Singleboardcomputer/hardware_for_kintex/config-spi.kicad_sch

## KiCad design config-spi.kicad_sch (2023-09-25)

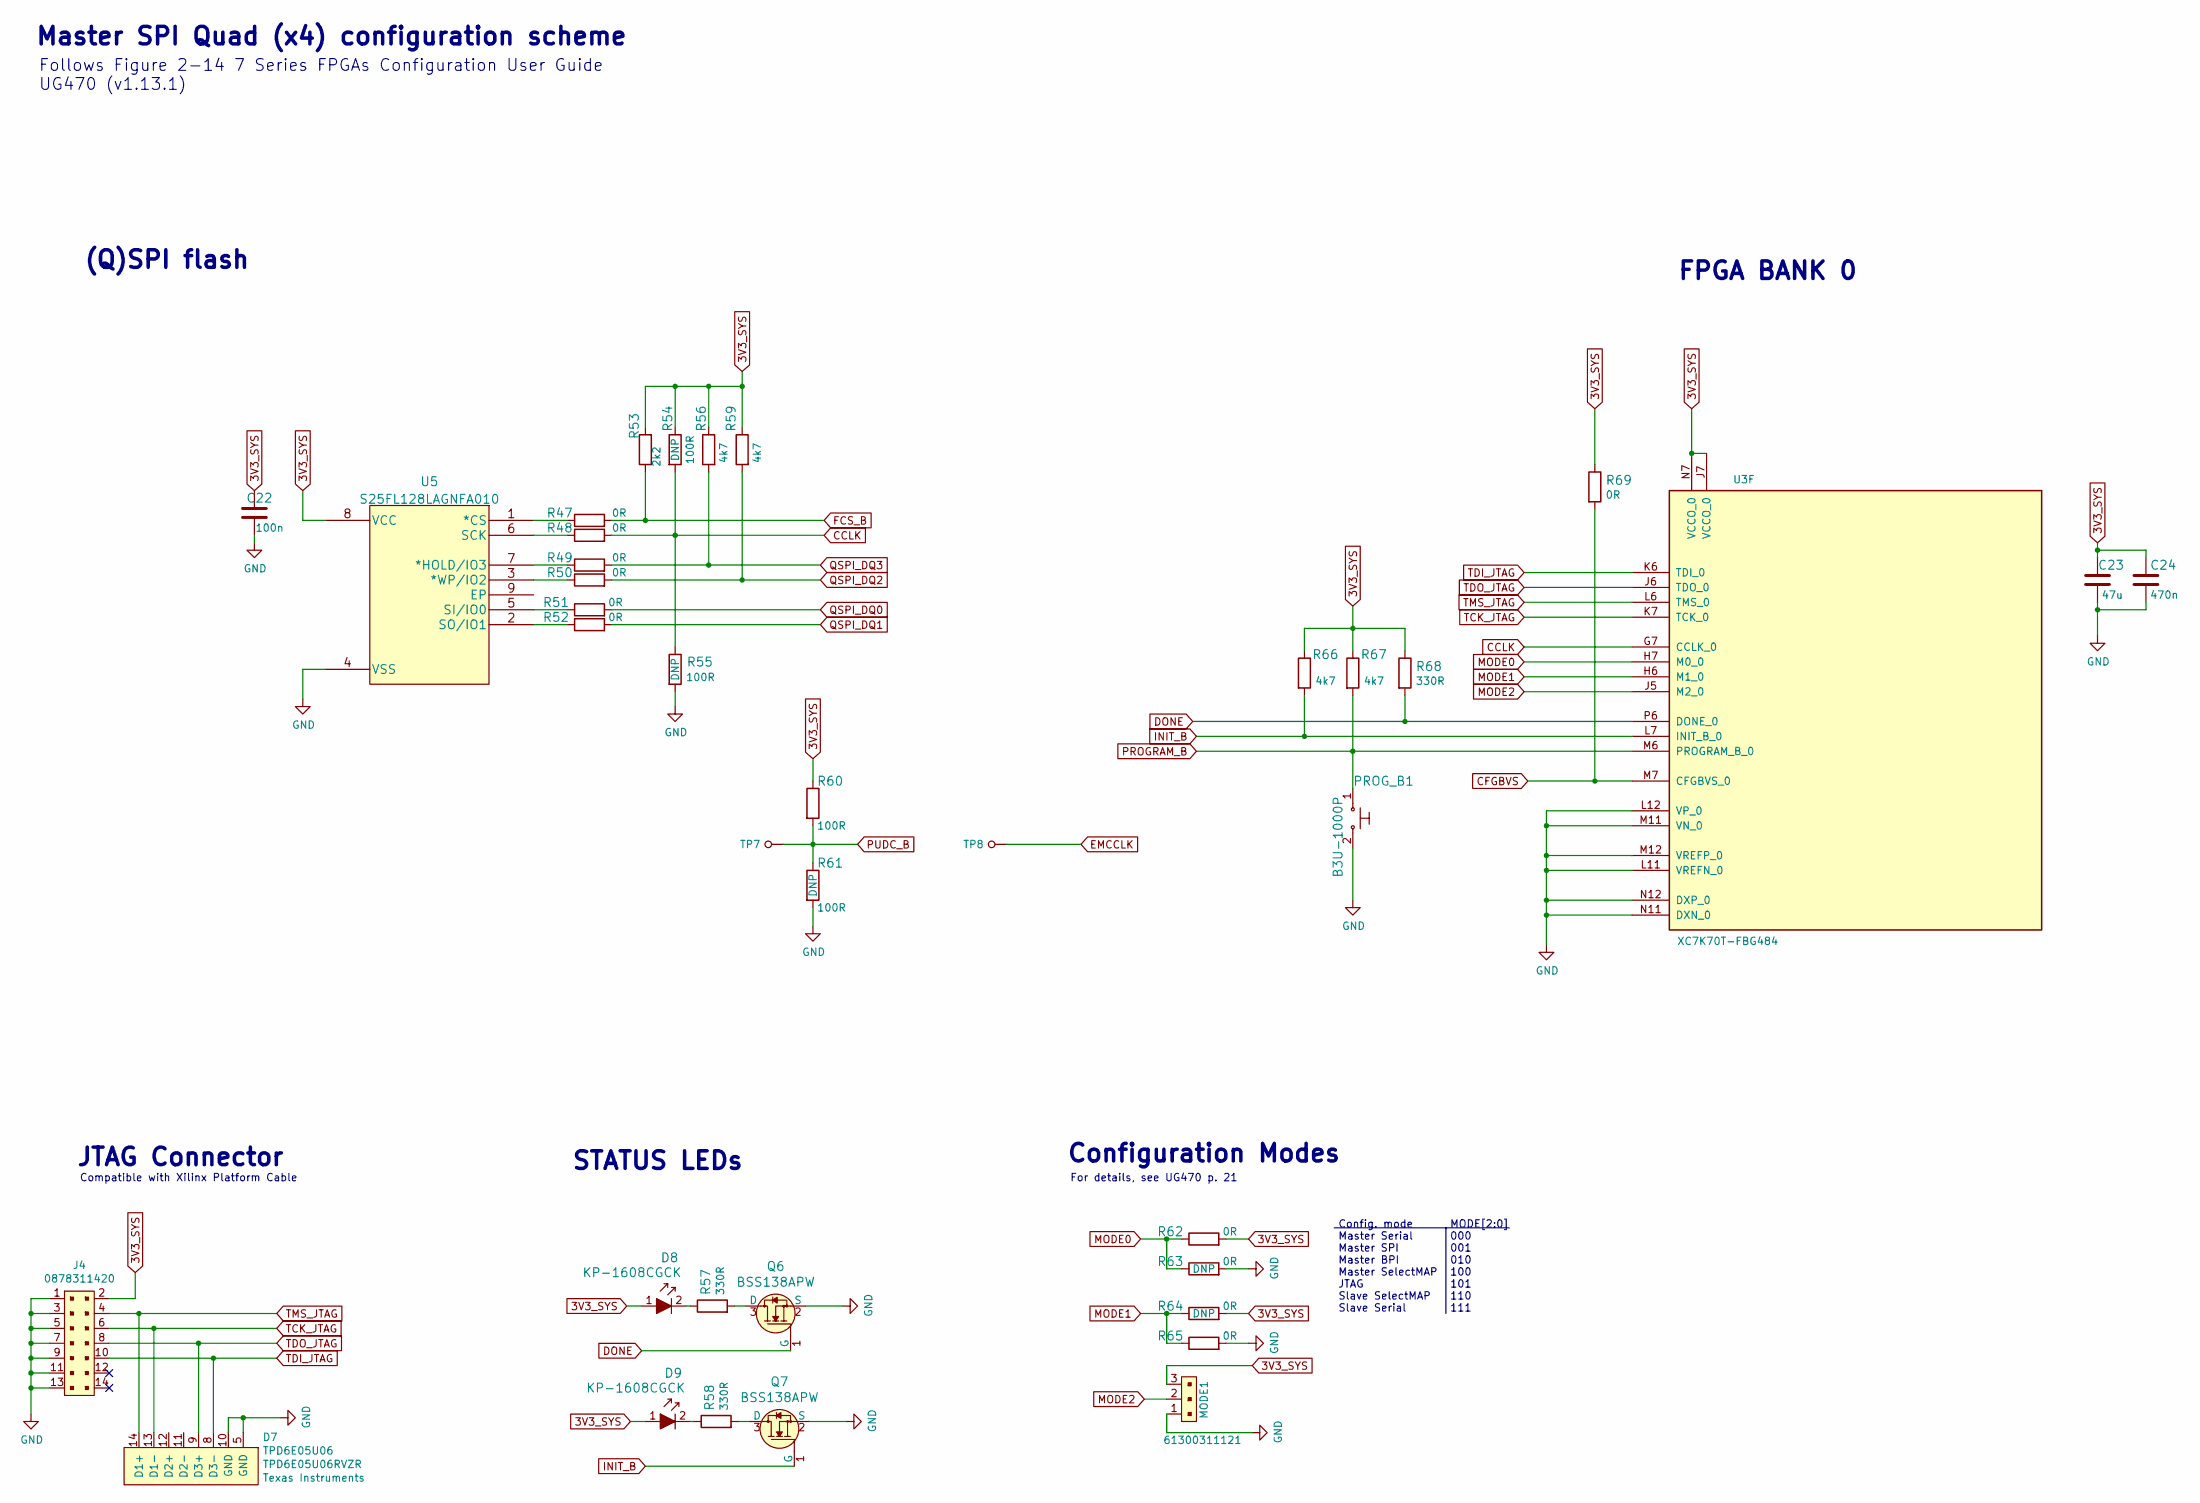
[picture p1: schematic config-spi.kicad_sch]

Parts:
C22: C_100n_0402_6V3; 0402-cap; MPN 0402X104K6R3CT
C23: C_47u_0603; 0603-cap; MPN GRM188R60J476ME15D
C24: C_470n_0402; 0402-cap; MPN C1005X5R1E474M050BB
D7: TPD6E05U06; MPN TPD6E05U06RVZR
D8, D9: KP-1608CGCK; LED_0603; MPN KP-1608CGCK
J4: 0878311420; PinHeader_2x7_P2mm_Drill1mm; MPN 0878311420
MODE1: 61300311121; PinHeader_1x3_P2.54_Drill1.1mm; MPN 61300311121
PROG_B1: B3U-1000P; Switch_Tactile_SMD_B3U-1000P; MPN B3U-1000P
Q6, Q7: BSS138APW; SC70-3; MPN BSS138PW
R47, R48, R49, R50, R51, R52, R62, R63, R64, R65, R69: R_0R_0402; 0402-res; MPN ERJ2GE0R00X
R53: R_2k2_0402; 0402-res; MPN RC0402FR-072K2L
R54, R55, R60, R61: R_100R_0402; 0402-res; MPN CR0402-FX-1000GLF
R56, R59, R66, R67: R_4k7_0402; 0402-res; MPN ERJ2GEJ472X
R57, R58, R68: R_330R_0402; 0402-res; MPN MCMR04X3300FTL
TP7, TP8: TP_SMD1MM; Testpoint_smd_1mm
U3: XC7K70T-FBG484; BGA484C100P22X22_2300X2300X244N; MPN XC7K70T-1FBG484C
U5: S25FL128LAGNFA010; S25FL128SAGNFI000; MPN S25FL128SAGNFI000

Connections:
3V3_SYS: C22.1, C23.1, C24.1, D8.1, D9.1, J4.2, MODE1.3, R53.2, R54.1, R56.1, R59.1, R60.1, R62.2, R64.2, R66.1, R67.1, R68.1, R69.1, U3.J7 (VCCO_0), U3.N7 (VCCO_0), U5.8 (VCC)
CCLK: R48.2, R54.2, R55.1, U3.G7 (CCLK_0)
CFGBVS: R69.2, U3.M7 (CFGBVS_0)
DONE: Q6.1 (G), R68.2, U3.P6 (DONE_0)
EMCCLK: TP8.1
FCS_B: R47.2, R53.1
GND: C22.2, C23.2, C24.2, D7.5 (GND), D7.10 (GND), J4.1, J4.3, J4.5, J4.7, J4.9, J4.11, J4.13, MODE1.1, PROG_B1.2, Q6.2 (S), Q7.2 (S), R55.2, R61.2, R63.2, R65.2, U3.L11 (VREFN_0), U3.L12 (VP_0), U3.M11 (VN_0), U3.M12 (VREFP_0), U3.N11 (DXN_0), U3.N12 (DXP_0), U5.4 (VSS)
INIT_B: Q7.1 (G), R66.2, U3.L7 (INIT_B_0)
MODE0: R62.1, R63.1, U3.H7 (M0_0)
MODE1: R64.1, R65.1, U3.H6 (M1_0)
MODE2: MODE1.2, U3.J5 (M2_0)
unnamed: D8.2, R57.1
unnamed: D9.2, R58.1
unnamed: Q6.3 (D), R57.2
unnamed: Q7.3 (D), R58.2
unnamed: R47.1, U5.1 (*CS)
unnamed: R48.1, U5.6 (SCK)
unnamed: R49.1, U5.7 (*HOLD/IO3)
unnamed: R50.1, U5.3 (*WP/IO2)
unnamed: R51.1, U5.5 (SI/IO0)
unnamed: R52.1, U5.2 (SO/IO1)
PROGRAM_B: PROG_B1.1, R67.2, U3.M6 (PROGRAM_B_0)
PUDC_B: R60.2, R61.1, TP7.1
QSPI_DQ0: R51.2
QSPI_DQ1: R52.2
QSPI_DQ2: R50.2, R59.2
QSPI_DQ3: R49.2, R56.2
TCK_JTAG: D7.13 (D1-), J4.6, U3.K7 (TCK_0)
TDI_JTAG: D7.8 (D3-), J4.10, U3.K6 (TDI_0)
TDO_JTAG: D7.9 (D3+), J4.8, U3.J6 (TDO_0)
TMS_JTAG: D7.14 (D1+), J4.4, U3.L6 (TMS_0)

Notes on the sheet:
Master SPI Quad (x4) configuration scheme
(Q)SPI flash
STATUS LEDs
Follows Figure 2-14 7 Series FPGAs Configuration User Guide UG470 (v1.13.1)
MODE[2:0] 000 001 010 100 101 110 111
For details, see UG470 p. 21
Compatible with Xilinx Platform Cable
Config. mode Master Serial Master SPI Master BPI Master SelectMAP JTAG Slave SelectMAP Slave Serial
JTAG Connector
Configuration Modes
FPGA BANK 0
