Singleboardcomputer/hardware_for_kintex/ethernet.kicad_sch

## KiCad design ethernet.kicad_sch (2023-09-25)

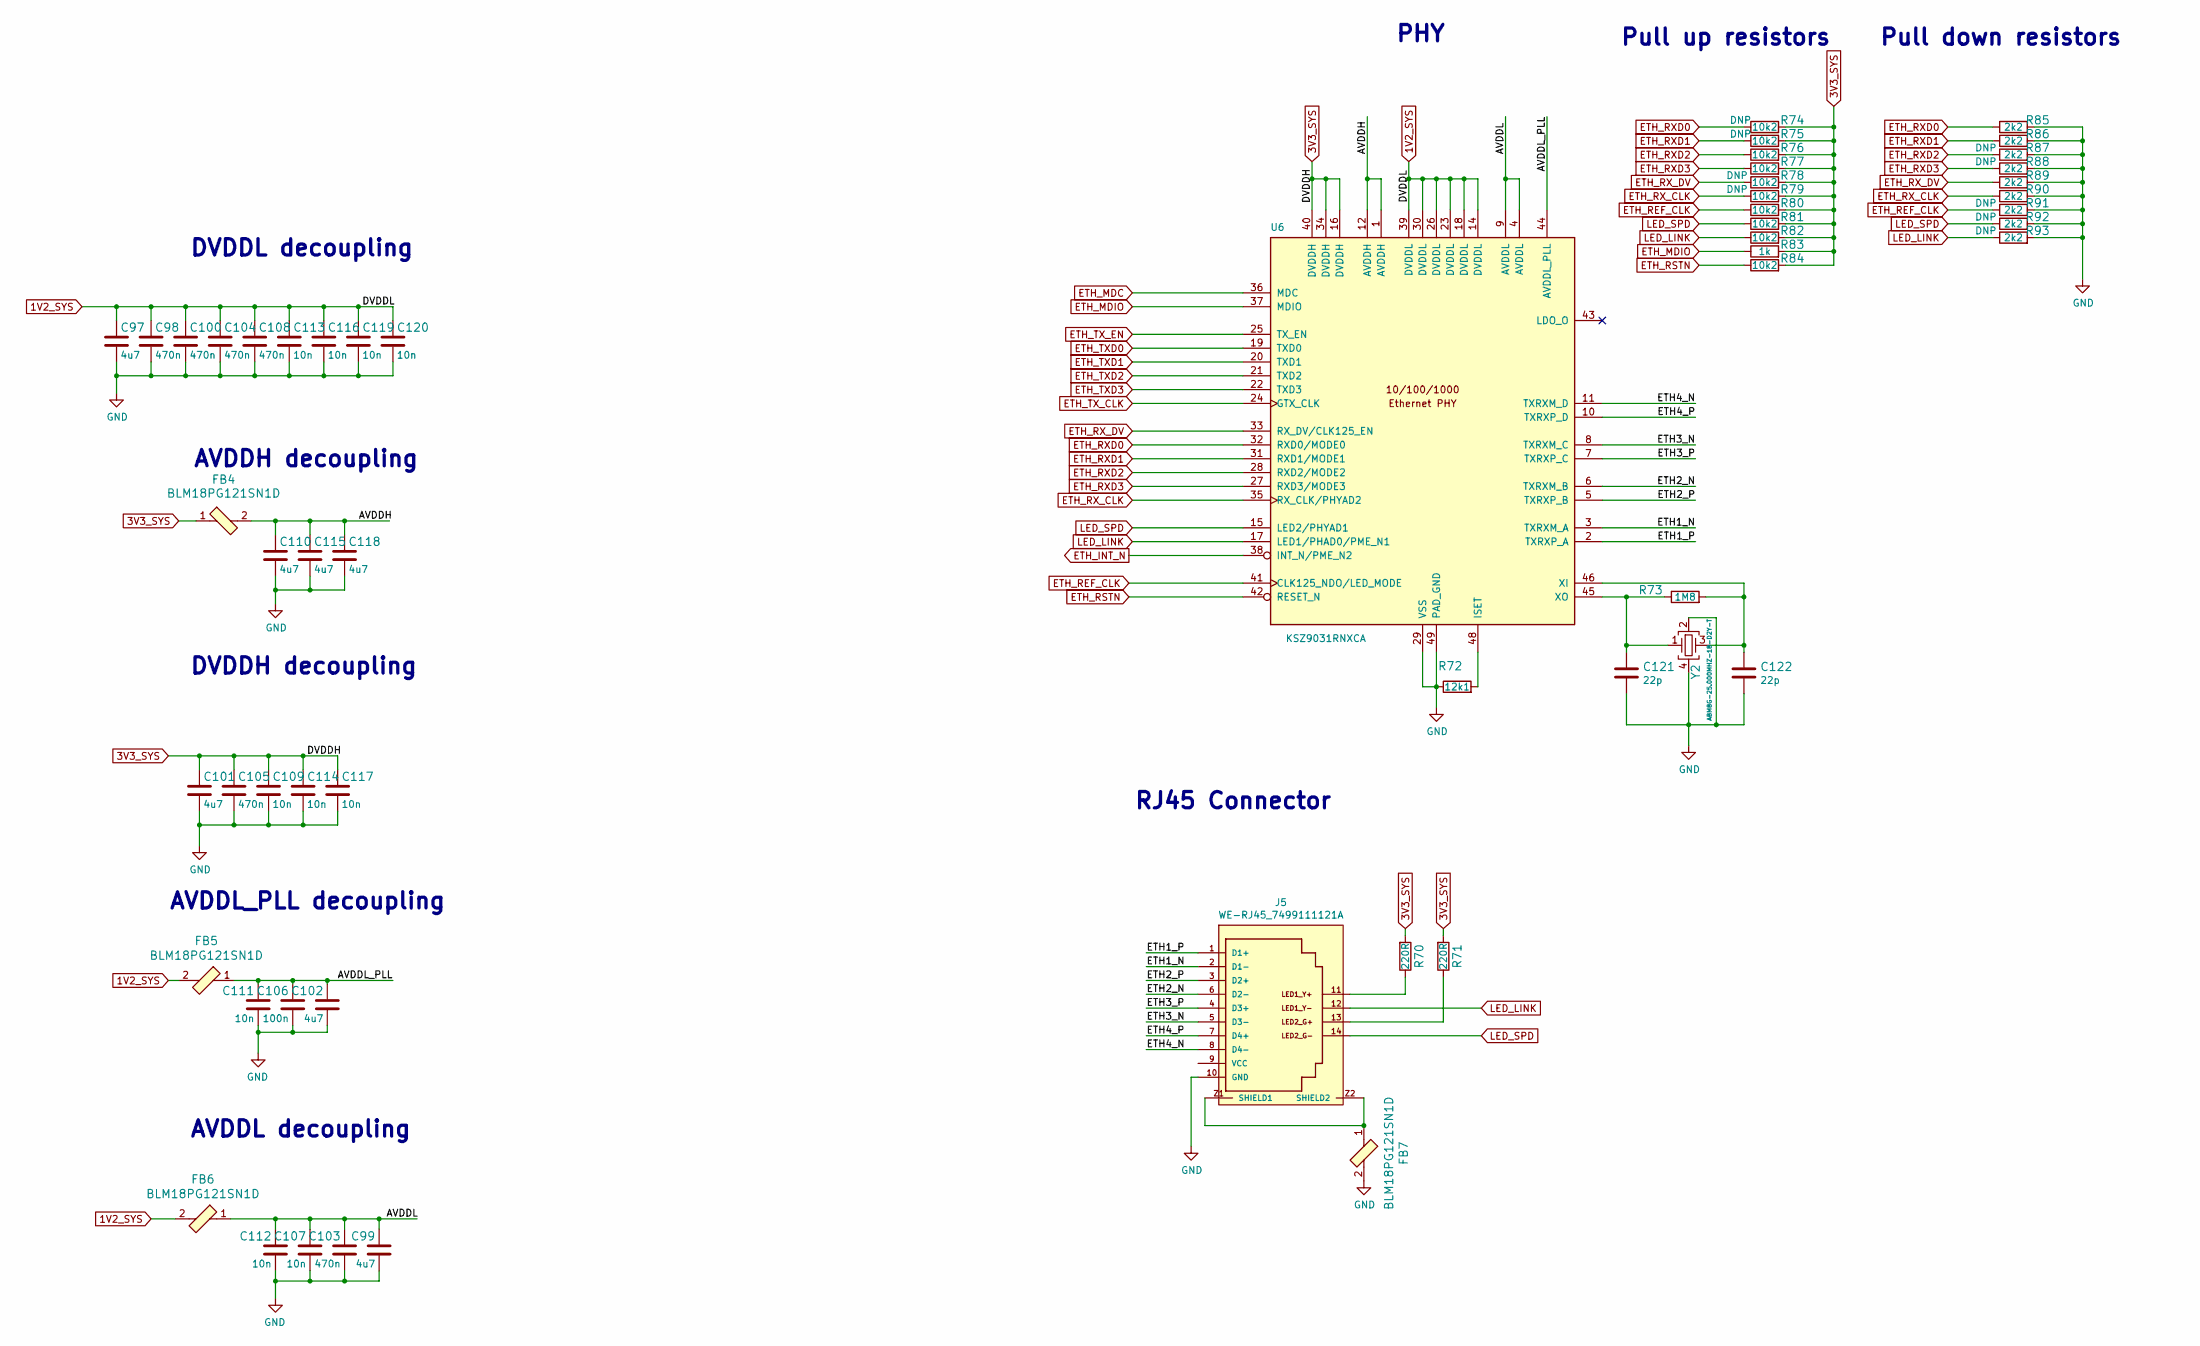
[picture p2: schematic ethernet.kicad_sch]

Parts:
C97, C99, C101, C102, C110: C_4u7_0402; 0402-cap; MPN GRM155R61A475MEAAD
C98, C100, C103, C104, C105: C_470n_0402; 0402-cap; MPN C1005X5R1E474M050BB
C106: C_100n_0402; 0402-cap; MPN MC0402B104K160CT
C107, C109, C111, C112, C113, C114, C116, C117, C119, C120: C_10n_0402; 0402-cap; MPN 04025G103ZAT2A
C108: C_10n_0402; 0402-cap; MPN C1005X5R1E474M050BB
C115, C118: C_10n_0402; 0402-cap; MPN GRM155R61A475MEAAD
C121, C122: C_22p_0402; 0402-cap; MPN CC0402JRNPO9BN220
FB4, FB5, FB6, FB7: BLM18PG121SN1D; 0603-res; MPN BLM18PG121SN1D
J5: WE-RJ45_7499111121A; 7499111121A; MPN 7499111121A
R70, R71: R_220R_0402; 0402-res; MPN ERJ2GEJ221X
R72: R_12k1_0402; 0402-res; MPN MCWR04X1212FTL
R73: R_1M8_0402; 0402-res; MPN MCMR04X185_JTL
R74, R75, R76, R77, R78, R79, R80, R81, R82, R84: R_10k2_0402; 0402-res; MPN MCWR04X1022FTL
R83: R_1k_0402; 0402-res; MPN CR0402-FX-1001GLF
R85, R86, R87, R88, R89, R90, R91, R92, R93: R_2k2_0402; 0402-res; MPN RC0402FR-072K2L
U6: KSZ9031RNXCA; QFN-48-Microchip-QFN77-48LD-PL-2; MPN KSZ9031RNXCA
Y2: ABM8G-25.000MHZ-18-D2Y-T; KX-7; MPN ABM8G-25.000MHZ-18-D2Y-T

Connections:
1V2_SYS: C97.1, C98.1, C100.1, C104.1, C108.1, C113.1, C116.1, C119.1, C120.1, FB5.2, FB6.2, U6.14 (DVDDL), U6.18 (DVDDL), U6.23 (DVDDL), U6.26 (DVDDL), U6.30 (DVDDL), U6.39 (DVDDL)
3V3_SYS: C101.1, C105.1, C109.1, C114.1, C117.1, FB4.1, R70.2, R71.2, R74.2, R75.2, R76.2, R77.2, R78.2, R79.2, R80.2, R81.2, R82.2, R83.2, R84.2, U6.16 (DVDDH), U6.34 (DVDDH), U6.40 (DVDDH)
AVDDH: C110.1, C115.1, C118.1, FB4.2, U6.1 (AVDDH), U6.12 (AVDDH)
AVDDL: C99.1, C103.1, C107.1, C112.1, FB6.1, U6.4 (AVDDL), U6.9 (AVDDL)
AVDDL_PLL: C102.1, C106.1, C111.1, FB5.1, U6.44 (AVDDL_PLL)
ETH1_N: J5.2 (D1-), U6.3 (TXRXM_A)
ETH1_P: J5.1 (D1+), U6.2 (TXRXP_A)
ETH2_N: J5.6 (D2-), U6.6 (TXRXM_B)
ETH2_P: J5.3 (D2+), U6.5 (TXRXP_B)
ETH3_N: J5.5 (D3-), U6.8 (TXRXM_C)
ETH3_P: J5.4 (D3+), U6.7 (TXRXP_C)
ETH4_N: J5.8 (D4-), U6.11 (TXRXM_D)
ETH4_P: J5.7 (D4+), U6.10 (TXRXP_D)
ETH_INT_N: U6.38 (INT_N/PME_N2)
ETH_MDC: U6.36 (MDC)
ETH_MDIO: R83.1, U6.37 (MDIO)
ETH_REF_CLK: R80.1, R91.1, U6.41 (CLK125_NDO/LED_MODE)
ETH_RSTN: R84.1, U6.42 (RESET_N)
ETH_RXD0: R74.1, R85.1, U6.32 (RXD0/MODE0)
ETH_RXD1: R75.1, R86.1, U6.31 (RXD1/MODE1)
ETH_RXD2: R76.1, R87.1, U6.28 (RXD2/MODE2)
ETH_RXD3: R77.1, R88.1, U6.27 (RXD3/MODE3)
ETH_RX_CLK: R79.1, R90.1, U6.35 (RX_CLK/PHYAD2)
ETH_RX_DV: R78.1, R89.1, U6.33 (RX_DV/CLK125_EN)
ETH_TXD0: U6.19 (TXD0)
ETH_TXD1: U6.20 (TXD1)
ETH_TXD2: U6.21 (TXD2)
ETH_TXD3: U6.22 (TXD3)
ETH_TX_CLK: U6.24 (GTX_CLK)
ETH_TX_EN: U6.25 (TX_EN)
GND: C97.2, C98.2, C99.2, C100.2, C101.2, C102.2, C103.2, C104.2, C105.2, C106.2, C107.2, C108.2, C109.2, C110.2, C111.2, C112.2, C113.2, C114.2, C115.2, C116.2, C117.2, C118.2, C119.2, C120.2, C121.2, C122.2, FB7.2, J5.10 (GND), R72.1, R85.2, R86.2, R87.2, R88.2, R89.2, R90.2, R91.2, R92.2, R93.2, U6.29 (VSS), U6.49 (PAD_GND), Y2.2, Y2.4
LED_LINK: J5.12, R82.1, R93.1, U6.17 (LED1/PHAD0/PME_N1)
LED_SPD: J5.14, R81.1, R92.1, U6.15 (LED2/PHYAD1)
unnamed: C121.1, R73.1, U6.45 (XO), Y2.1
unnamed: C122.1, R73.2, U6.46 (XI), Y2.3
unnamed: FB7.1, J5.Z1 (SHIELD1), J5.Z2 (SHIELD2)
unnamed: J5.11, R70.1
unnamed: J5.13, R71.1
unnamed: R72.2, U6.48 (ISET)

Notes on the sheet:
AVDDH decoupling
DVDDH decoupling
DVDDL decoupling
AVDDL_PLL decoupling
PHY
Pull down resistors
AVDDL decoupling
Pull up resistors
RJ45 Connector
