Singleboardcomputer/hardware_for_kintex/fpga-banks.kicad_sch

## KiCad design fpga-banks.kicad_sch (2023-09-25)

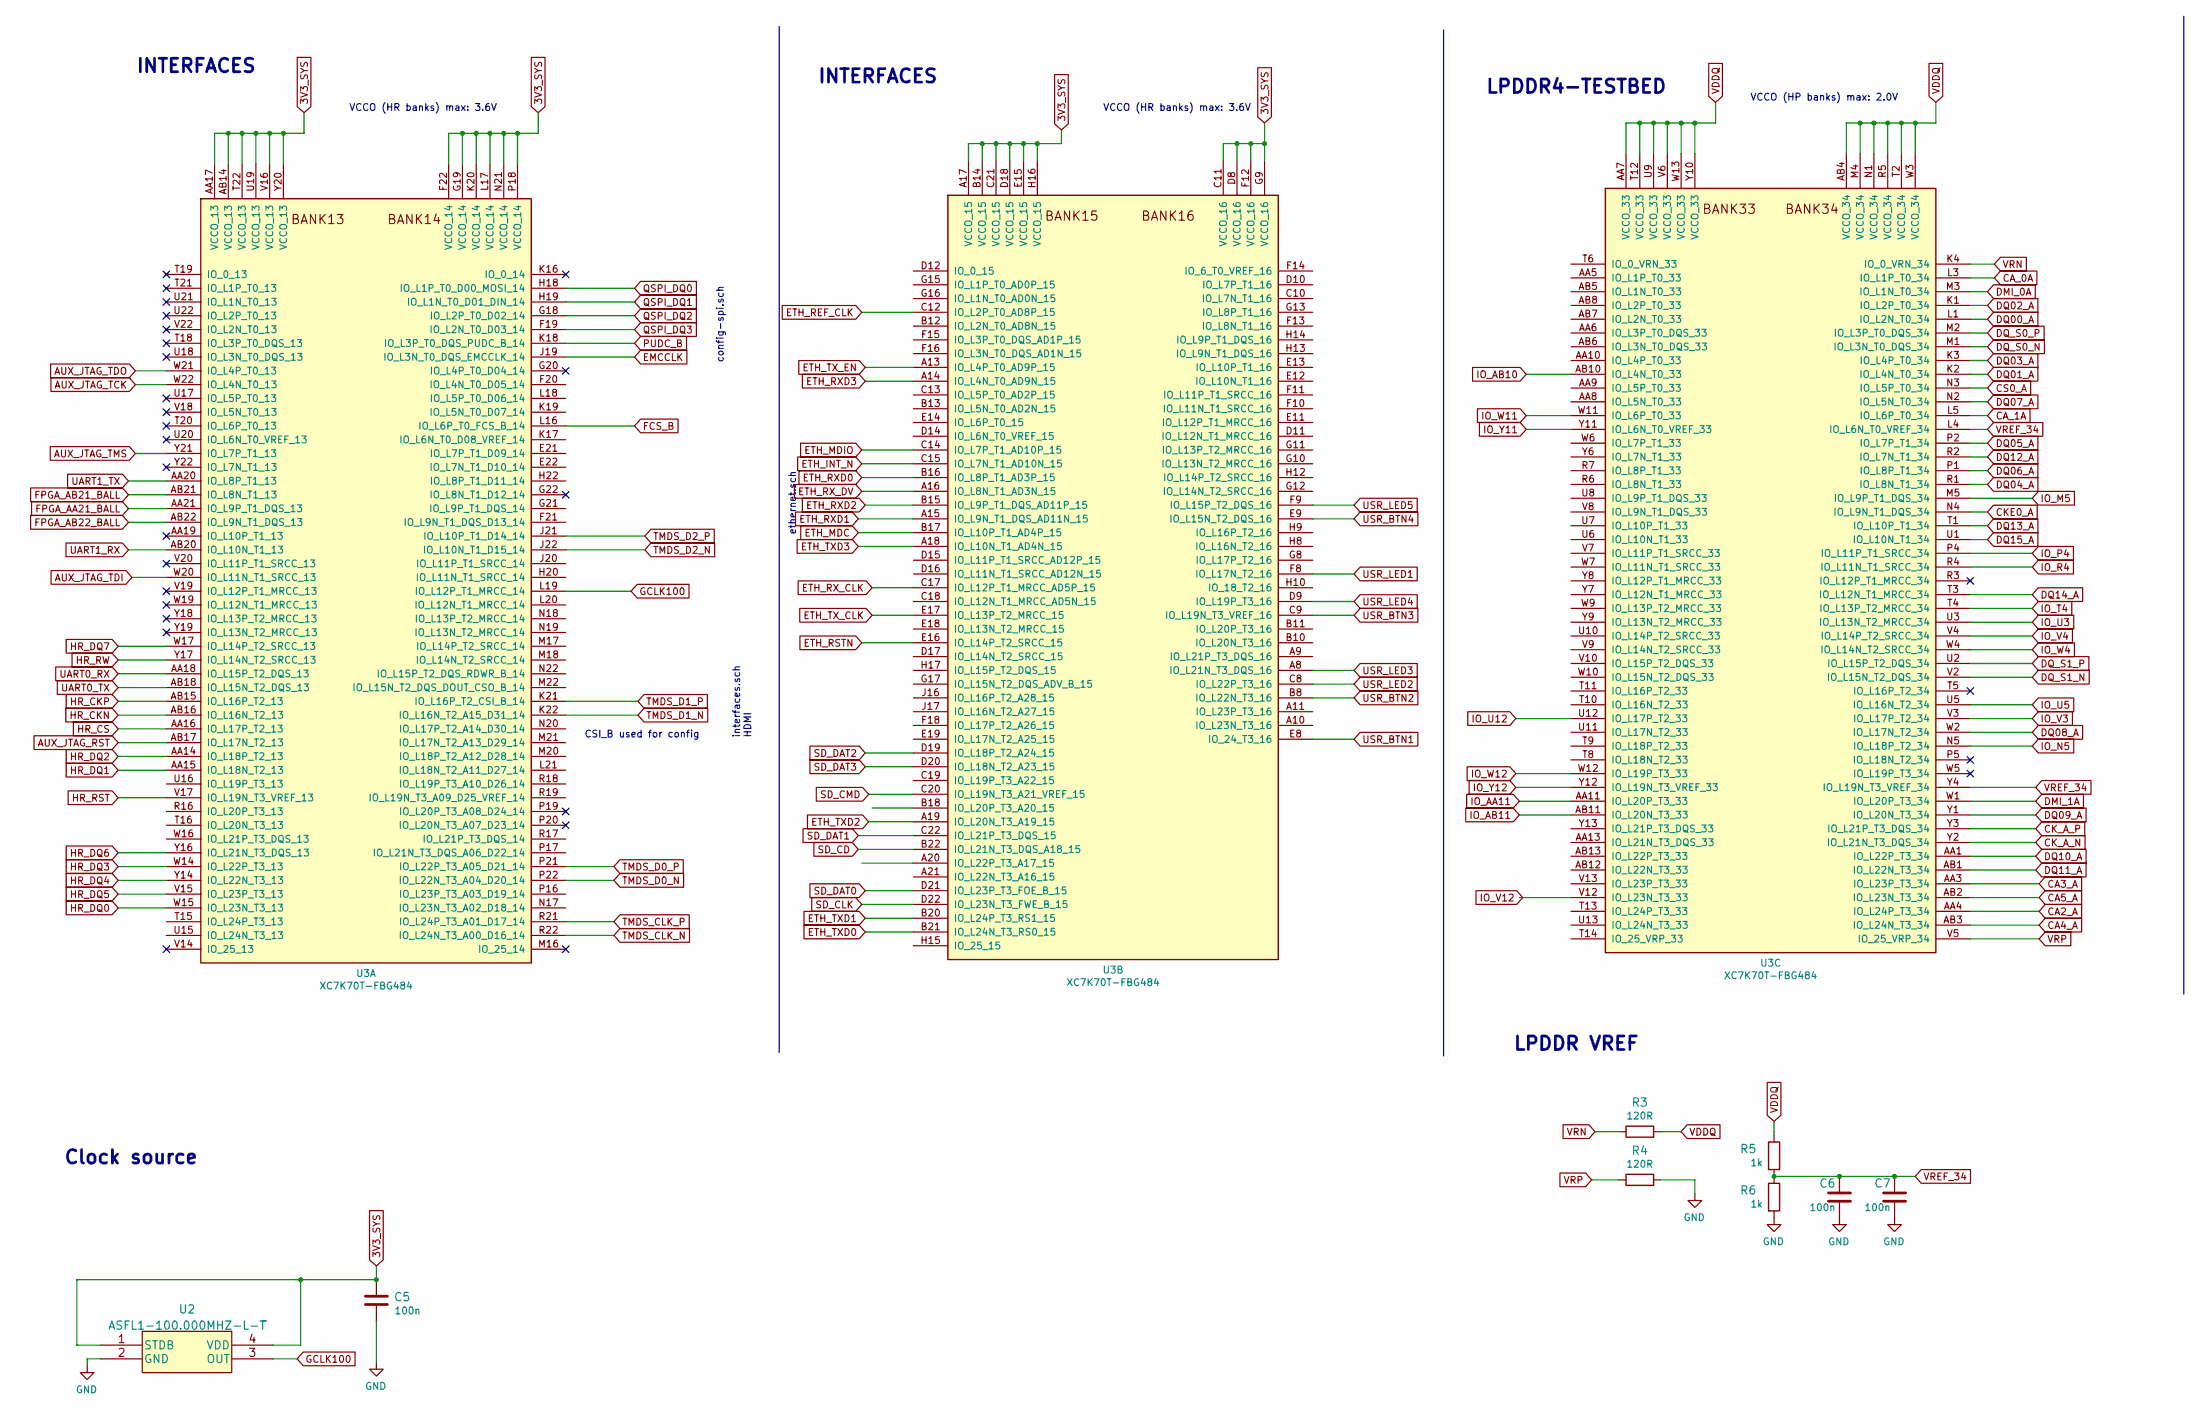
[picture p3: schematic fpga-banks.kicad_sch]

Parts:
C5, C6, C7: C_100n_0402_6V3; 0402-cap; MPN 0402X104K6R3CT
R3, R4: R_120R_0603; 0603-res; MPN CRCW0603120RFKEA
R5, R6: R_1k_0603; 0603-res; MPN CR0603-JW-102ELF
U2: ASFL1-100.000MHZ-L-T; Oscillator_SMD_Abracon_ASFL1-4Pin_5.0x3.2mm; MPN ASFL1-100.000MHZ-L-T
U3: XC7K70T-FBG484; BGA484C100P22X22_2300X2300X244N; MPN XC7K70T-1FBG484C

Connections:
3V3_SYS: C5.1, U2.1 (STDB), U2.4 (VDD), U3.A17 (VCCO_15), U3.AA17 (VCCO_13), U3.AB14 (VCCO_13), U3.B14 (VCCO_15), U3.C11 (VCCO_16), U3.C21 (VCCO_15), U3.D8 (VCCO_16), U3.D18 (VCCO_15), U3.E15 (VCCO_15), U3.F12 (VCCO_16), U3.F22 (VCCO_14), U3.G9 (VCCO_16), U3.G19 (VCCO_14), U3.H16 (VCCO_15), U3.K20 (VCCO_14), U3.L17 (VCCO_14), U3.N21 (VCCO_14), U3.P18 (VCCO_14), U3.T22 (VCCO_13), U3.U19 (VCCO_13), U3.V16 (VCCO_13), U3.Y20 (VCCO_13)
AUX_JTAG_RST: U3.AB17 (IO_L17N_T2_13)
AUX_JTAG_TCK: U3.W22 (IO_L4N_T0_13)
AUX_JTAG_TDI: U3.W20 (IO_L11N_T1_SRCC_13)
AUX_JTAG_TDO: U3.W21 (IO_L4P_T0_13)
AUX_JTAG_TMS: U3.Y21 (IO_L7P_T1_13)
CA2_A: U3.AA4 (IO_L24P_T3_34)
CA3_A: U3.AA3 (IO_L23P_T3_34)
CA4_A: U3.AB3 (IO_L24N_T3_34)
CA5_A: U3.AB2 (IO_L23N_T3_34)
CA_0A: U3.L3 (IO_L1P_T0_34)
CA_1A: U3.L5 (IO_L6P_T0_34)
CKE0_A: U3.N4 (IO_L9N_T1_DQS_34)
CK_A_N: U3.Y2 (IO_L21N_T3_DQS_34)
CK_A_P: U3.Y3 (IO_L21P_T3_DQS_34)
CS0_A: U3.N3 (IO_L5P_T0_34)
DMI_0A: U3.M3 (IO_L1N_T0_34)
DMI_1A: U3.W1 (IO_L20P_T3_34)
DQ00_A: U3.L1 (IO_L2N_T0_34)
DQ01_A: U3.K2 (IO_L4N_T0_34)
DQ02_A: U3.K1 (IO_L2P_T0_34)
DQ03_A: U3.K3 (IO_L4P_T0_34)
DQ04_A: U3.R1 (IO_L8N_T1_34)
DQ05_A: U3.P2 (IO_L7P_T1_34)
DQ06_A: U3.P1 (IO_L8P_T1_34)
DQ07_A: U3.N2 (IO_L5N_T0_34)
DQ08_A: U3.W2 (IO_L17N_T2_34)
DQ09_A: U3.Y1 (IO_L20N_T3_34)
DQ10_A: U3.AA1 (IO_L22P_T3_34)
DQ11_A: U3.AB1 (IO_L22N_T3_34)
DQ12_A: U3.R2 (IO_L7N_T1_34)
DQ13_A: U3.T1 (IO_L10P_T1_34)
DQ14_A: U3.T3 (IO_L12N_T1_MRCC_34)
DQ15_A: U3.U1 (IO_L10N_T1_34)
DQ_S0_N: U3.M1 (IO_L3N_T0_DQS_34)
DQ_S0_P: U3.M2 (IO_L3P_T0_DQS_34)
DQ_S1_N: U3.V2 (IO_L15N_T2_DQS_34)
DQ_S1_P: U3.U2 (IO_L15P_T2_DQS_34)
EMCCLK: U3.J19 (IO_L3N_T0_DQS_EMCCLK_14)
ETH_INT_N: U3.C15 (IO_L7N_T1_AD10N_15)
ETH_MDC: U3.B17 (IO_L10P_T1_AD4P_15)
ETH_MDIO: U3.C14 (IO_L7P_T1_AD10P_15)
ETH_REF_CLK: U3.C12 (IO_L2P_T0_AD8P_15)
ETH_RSTN: U3.E16 (IO_L14P_T2_SRCC_15)
ETH_RXD0: U3.B16 (IO_L8P_T1_AD3P_15)
ETH_RXD1: U3.A15 (IO_L9N_T1_DQS_AD11N_15)
ETH_RXD2: U3.B15 (IO_L9P_T1_DQS_AD11P_15)
ETH_RXD3: U3.A14 (IO_L4N_T0_AD9N_15)
ETH_RX_CLK: U3.C17 (IO_L12P_T1_MRCC_AD5P_15)
ETH_RX_DV: U3.A16 (IO_L8N_T1_AD3N_15)
ETH_TXD0: U3.B21 (IO_L24N_T3_RS0_15)
ETH_TXD1: U3.B20 (IO_L24P_T3_RS1_15)
ETH_TXD2: U3.A19 (IO_L20N_T3_A19_15)
ETH_TXD3: U3.A18 (IO_L10N_T1_AD4N_15)
ETH_TX_CLK: U3.E17 (IO_L13P_T2_MRCC_15)
ETH_TX_EN: U3.A13 (IO_L4P_T0_AD9P_15)
FCS_B: U3.L16 (IO_L6P_T0_FCS_B_14)
FPGA_AA21_BALL: U3.AA21 (IO_L9P_T1_DQS_13)
FPGA_AB21_BALL: U3.AB21 (IO_L8N_T1_13)
FPGA_AB22_BALL: U3.AB22 (IO_L9N_T1_DQS_13)
GCLK100: U2.3 (OUT), U3.L19 (IO_L12P_T1_MRCC_14)
GND: C5.2, C6.2, C7.2, R4.2, R6.2, U2.2 (GND)
HR_CKN: U3.AB16 (IO_L16N_T2_13)
HR_CKP: U3.AB15 (IO_L16P_T2_13)
HR_CS: U3.AA16 (IO_L17P_T2_13)
HR_DQ0: U3.W15 (IO_L23N_T3_13)
HR_DQ1: U3.AA15 (IO_L18N_T2_13)
HR_DQ2: U3.AA14 (IO_L18P_T2_13)
HR_DQ3: U3.W14 (IO_L22P_T3_13)
HR_DQ4: U3.Y14 (IO_L22N_T3_13)
HR_DQ5: U3.V15 (IO_L23P_T3_13)
HR_DQ6: U3.Y16 (IO_L21N_T3_DQS_13)
HR_DQ7: U3.W17 (IO_L14P_T2_SRCC_13)
HR_RST: U3.V17 (IO_L19N_T3_VREF_13)
HR_RW: U3.Y17 (IO_L14N_T2_SRCC_13)
IO_AA11: U3.AA11 (IO_L20P_T3_33)
IO_AB10: U3.AB10 (IO_L4N_T0_33)
IO_AB11: U3.AB11 (IO_L20N_T3_33)
IO_M5: U3.M5 (IO_L9P_T1_DQS_34)
IO_N5: U3.N5 (IO_L18P_T2_34)
IO_P4: U3.P4 (IO_L11P_T1_SRCC_34)
IO_R4: U3.R4 (IO_L11N_T1_SRCC_34)
IO_T4: U3.T4 (IO_L13P_T2_MRCC_34)
IO_U3: U3.U3 (IO_L13N_T2_MRCC_34)
IO_U5: U3.U5 (IO_L16N_T2_34)
IO_U12: U3.U12 (IO_L17P_T2_33)
IO_V3: U3.V3 (IO_L17P_T2_34)
IO_V4: U3.V4 (IO_L14P_T2_SRCC_34)
IO_V12: U3.V12 (IO_L23N_T3_33)
IO_W4: U3.W4 (IO_L14N_T2_SRCC_34)
IO_W11: U3.W11 (IO_L6P_T0_33)
IO_W12: U3.W12 (IO_L19P_T3_33)
IO_Y11: U3.Y11 (IO_L6N_T0_VREF_33)
IO_Y12: U3.Y12 (IO_L19N_T3_VREF_33)
PUDC_B: U3.K18 (IO_L3P_T0_DQS_PUDC_B_14)
QSPI_DQ0: U3.H18 (IO_L1P_T0_D00_MOSI_14)
QSPI_DQ1: U3.H19 (IO_L1N_T0_D01_DIN_14)
QSPI_DQ2: U3.G18 (IO_L2P_T0_D02_14)
QSPI_DQ3: U3.F19 (IO_L2N_T0_D03_14)
SD_CD: U3.B22 (IO_L21N_T3_DQS_A18_15)
SD_CLK: U3.D22 (IO_L23N_T3_FWE_B_15)
SD_CMD: U3.C20 (IO_L19N_T3_A21_VREF_15)
SD_DAT0: U3.D21 (IO_L23P_T3_FOE_B_15)
SD_DAT1: U3.C22 (IO_L21P_T3_DQS_15)
SD_DAT2: U3.D19 (IO_L18P_T2_A24_15)
SD_DAT3: U3.D20 (IO_L18N_T2_A23_15)
TMDS_CLK_N: U3.R22 (IO_L24N_T3_A00_D16_14)
TMDS_CLK_P: U3.R21 (IO_L24P_T3_A01_D17_14)
TMDS_D0_N: U3.P22 (IO_L22N_T3_A04_D20_14)
TMDS_D0_P: U3.P21 (IO_L22P_T3_A05_D21_14)
TMDS_D1_N: U3.K22 (IO_L16N_T2_A15_D31_14)
TMDS_D1_P: U3.K21 (IO_L16P_T2_CSI_B_14)
TMDS_D2_N: U3.J22 (IO_L10N_T1_D15_14)
TMDS_D2_P: U3.J21 (IO_L10P_T1_D14_14)
UART0_RX: U3.AA18 (IO_L15P_T2_DQS_13)
UART0_TX: U3.AB18 (IO_L15N_T2_DQS_13)
UART1_RX: U3.AB20 (IO_L10N_T1_13)
UART1_TX: U3.AA20 (IO_L8P_T1_13)
USR_BTN1: U3.E8 (IO_24_T3_16)
USR_BTN2: U3.B8 (IO_L22N_T3_16)
USR_BTN3: U3.C9 (IO_L19N_T3_VREF_16)
USR_BTN4: U3.E9 (IO_L15N_T2_DQS_16)
USR_LED1: U3.F8 (IO_L17N_T2_16)
USR_LED2: U3.C8 (IO_L22P_T3_16)
USR_LED3: U3.A8 (IO_L21N_T3_DQS_16)
USR_LED4: U3.D9 (IO_L19P_T3_16)
USR_LED5: U3.F9 (IO_L15P_T2_DQS_16)
VDDQ: R3.2, R5.1, U3.AA7 (VCCO_33), U3.AB4 (VCCO_34), U3.M4 (VCCO_34), U3.N1 (VCCO_34), U3.R5 (VCCO_34), U3.T2 (VCCO_34), U3.T12 (VCCO_33), U3.U9 (VCCO_33), U3.V6 (VCCO_33), U3.W3 (VCCO_34), U3.W13 (VCCO_33), U3.Y10 (VCCO_33)
VREF_34: C6.1, C7.1, R5.2, R6.1, U3.L4 (IO_L6N_T0_VREF_34), U3.Y4 (IO_L19N_T3_VREF_34)
VRN: R3.1, U3.K4 (IO_0_VRN_34)
VRP: R4.1, U3.V5 (IO_25_VRP_34)

Notes on the sheet:
Clock source
INTERFACES
VCCO (HP banks) max: 2.0V
CSI_B used for config
ethernet.sch
LPDDR VREF
interfaces.sch HDMI
VCCO (HR banks) max: 3.6V
LPDDR4-TESTBED
config-spi.sch
