Singleboardcomputer/hardware_for_kintex/fpga-power.kicad_sch

## KiCad design fpga-power.kicad_sch (2023-09-25)

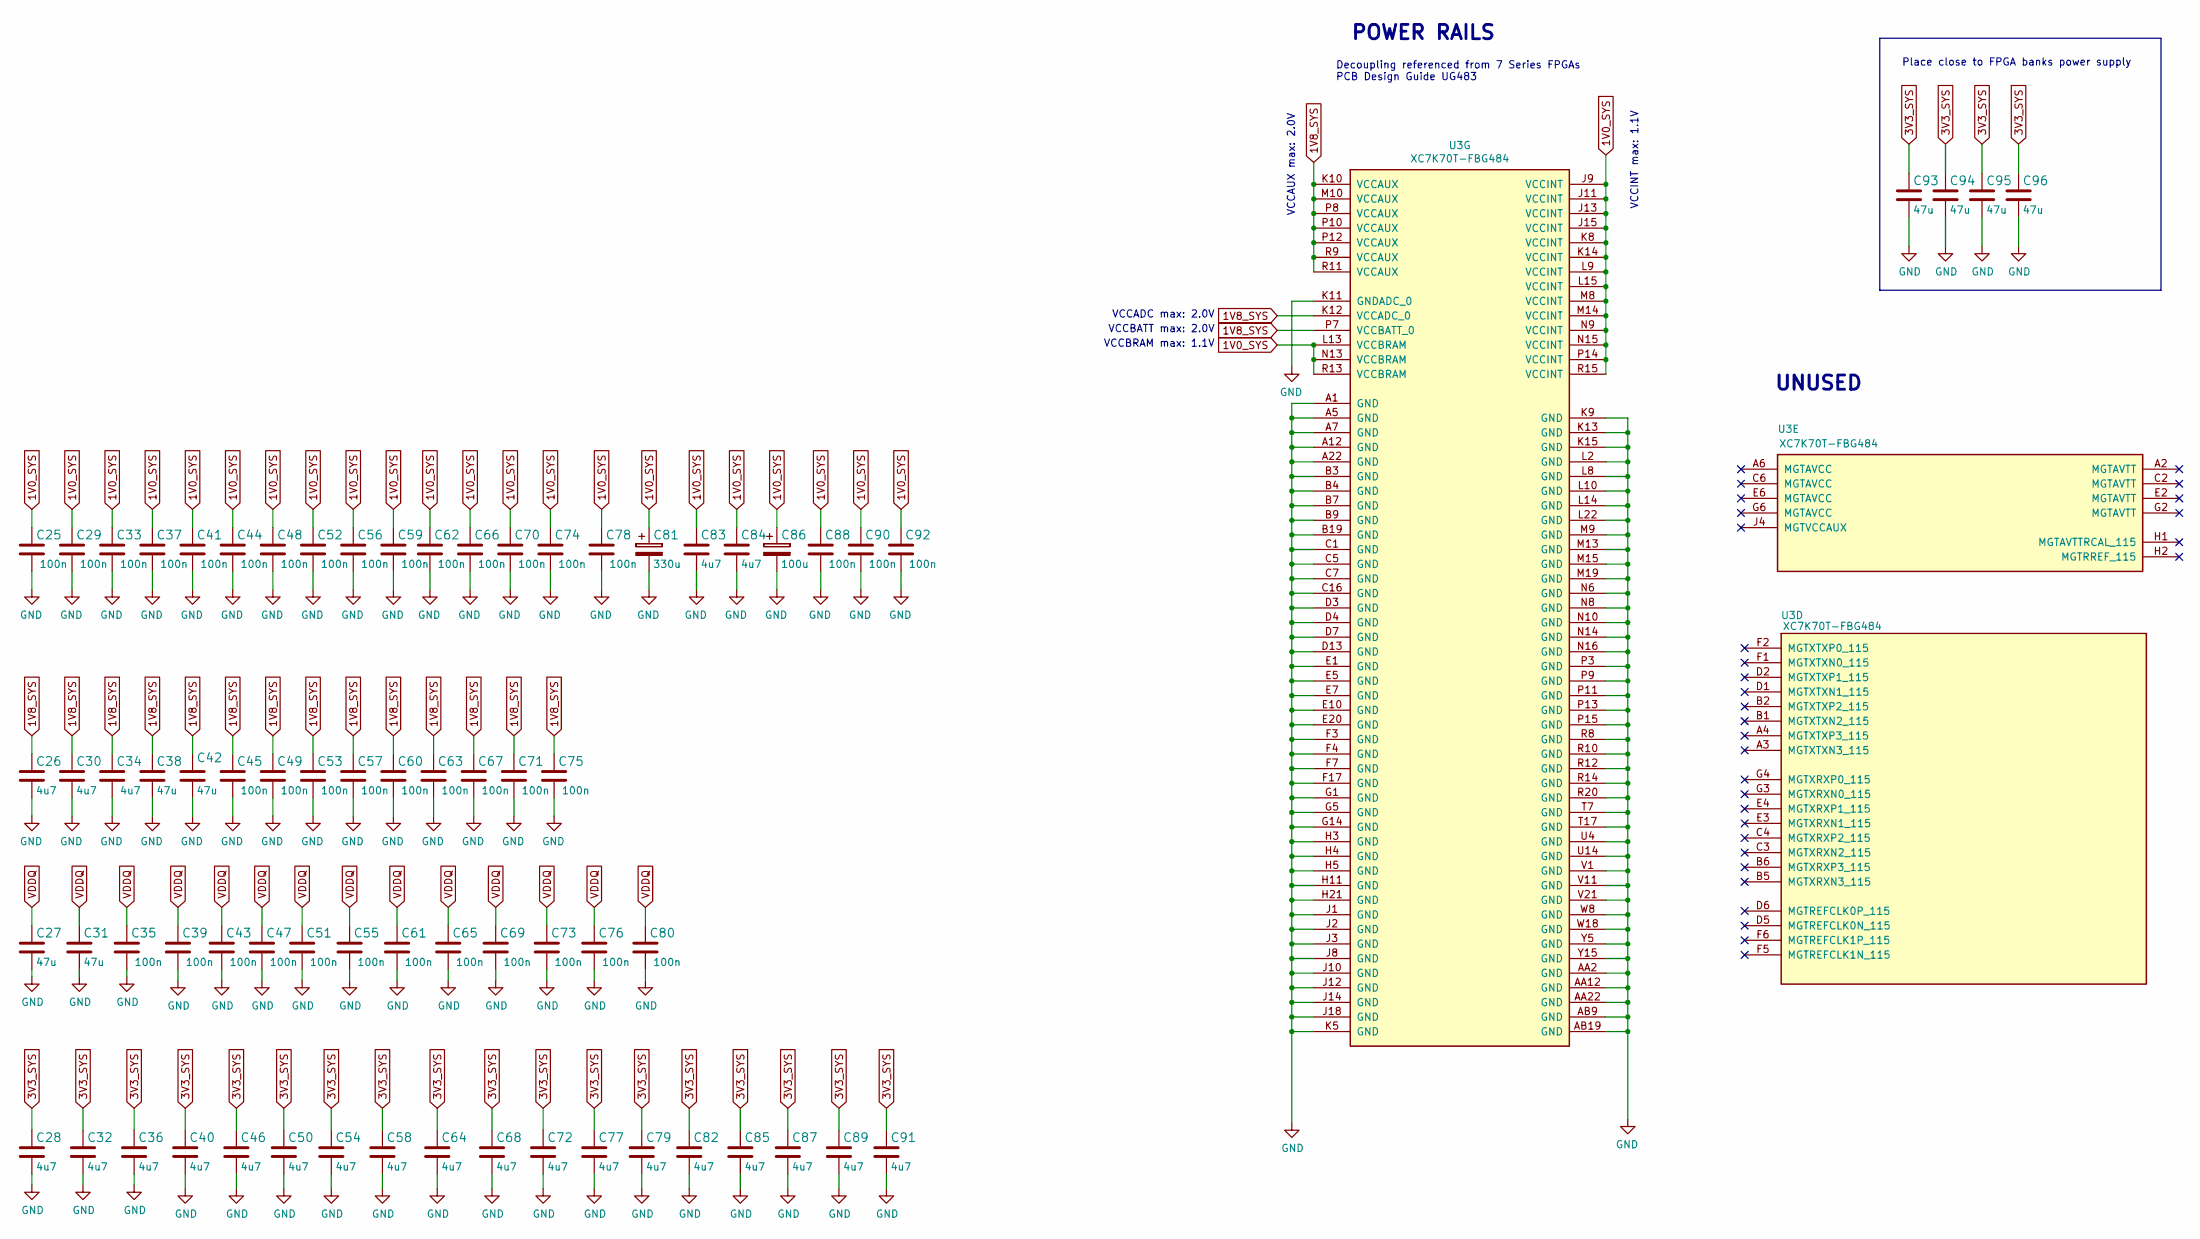
[picture p4: schematic fpga-power.kicad_sch]

Parts:
C25, C29, C33, C35, C37, C39, C41, C43, C44, C45, C47, C48, C49, C51, C52, C53, C55, C56, C57, C59, C60, C61, C62, C63, C65, C66, C67, C69, C70, C71, C73, C74, C75, C76, C78, C80, C88, C90, C92: C_100n_0201; 0201-res; MPN CC0201KRX6S5BB104
C26, C28, C30, C32, C34, C36, C40, C46, C50, C54, C58, C64, C68, C72, C77, C79, C82, C83, C84, C85, C87, C89, C91: C_4u7_0402; 0402-cap; MPN GRM155R61A475MEAAD
C27, C31, C38, C42, C93, C94, C95, C96: C_47u_0603; 0603-cap; MPN GRM188R60J476ME15D
C81: C_330u_KEMET_D; KEMET_D; MPN T520D337M006ATE045
C86: C_100u_KEMET_A; KEMET_A; MPN 298D107X06R3A2T
U3: XC7K70T-FBG484; BGA484C100P22X22_2300X2300X244N; MPN XC7K70T-1FBG484C

Connections:
1V0_SYS: C25.1, C29.1, C33.1, C37.1, C41.1, C44.1, C48.1, C52.1, C56.1, C59.1, C62.1, C66.1, C70.1, C74.1, C78.1, C81.1, C83.1, C84.1, C86.1, C88.1, C90.1, C92.1, U3.J9 (VCCINT), U3.J11 (VCCINT), U3.J13 (VCCINT), U3.J15 (VCCINT), U3.K8 (VCCINT), U3.K14 (VCCINT), U3.L9 (VCCINT), U3.L13 (VCCBRAM), U3.L15 (VCCINT), U3.M8 (VCCINT), U3.M14 (VCCINT), U3.N9 (VCCINT), U3.N13 (VCCBRAM), U3.N15 (VCCINT), U3.P14 (VCCINT), U3.R13 (VCCBRAM), U3.R15 (VCCINT)
1V8_SYS: C26.1, C30.1, C34.1, C38.1, C42.1, C45.1, C49.1, C53.1, C57.1, C60.1, C63.1, C67.1, C71.1, C75.1, U3.K10 (VCCAUX), U3.K12 (VCCADC_0), U3.M10 (VCCAUX), U3.P7 (VCCBATT_0), U3.P8 (VCCAUX), U3.P10 (VCCAUX), U3.P12 (VCCAUX), U3.R9 (VCCAUX), U3.R11 (VCCAUX)
3V3_SYS: C28.1, C32.1, C36.1, C40.1, C46.1, C50.1, C54.1, C58.1, C64.1, C68.1, C72.1, C77.1, C79.1, C82.1, C85.1, C87.1, C89.1, C91.1, C93.1, C94.1, C95.1, C96.1
GND: C25.2, C26.2, C27.2, C28.2, C29.2, C30.2, C31.2, C32.2, C33.2, C34.2, C35.2, C36.2, C37.2, C38.2, C39.2, C40.2, C41.2, C42.2, C43.2, C44.2, C45.2, C46.2, C47.2, C48.2, C49.2, C50.2, C51.2, C52.2, C53.2, C54.2, C55.2, C56.2, C57.2, C58.2, C59.2, C60.2, C61.2, C62.2, C63.2, C64.2, C65.2, C66.2, C67.2, C68.2, C69.2, C70.2, C71.2, C72.2, C73.2, C74.2, C75.2, C76.2, C77.2, C78.2, C79.2, C80.2, C81.2, C82.2, C83.2, C84.2, C85.2, C86.2, C87.2, C88.2, C89.2, C90.2, C91.2, C92.2, C93.2, C94.2, C95.2, C96.2, U3.A1 (GND), U3.A5 (GND), U3.A7 (GND), U3.A12 (GND), U3.A22 (GND), U3.AA2 (GND), U3.AA12 (GND), U3.AA22 (GND), U3.AB9 (GND), U3.AB19 (GND), U3.B3 (GND), U3.B4 (GND), U3.B7 (GND), U3.B9 (GND), U3.B19 (GND), U3.C1 (GND), U3.C5 (GND), U3.C7 (GND), U3.C16 (GND), U3.D3 (GND), U3.D4 (GND), U3.D7 (GND), U3.D13 (GND), U3.E1 (GND), U3.E5 (GND), U3.E7 (GND), U3.E10 (GND), U3.E20 (GND), U3.F3 (GND), U3.F4 (GND), U3.F7 (GND), U3.F17 (GND), U3.G1 (GND), U3.G5 (GND), U3.G14 (GND), U3.H3 (GND), U3.H4 (GND), U3.H5 (GND), U3.H11 (GND), U3.H21 (GND), U3.J1 (GND), U3.J2 (GND), U3.J3 (GND), U3.J8 (GND), U3.J10 (GND), U3.J12 (GND), U3.J14 (GND), U3.J18 (GND), U3.K5 (GND), U3.K9 (GND), U3.K11 (GNDADC_0), U3.K13 (GND), U3.K15 (GND), U3.L2 (GND), U3.L8 (GND), U3.L10 (GND), U3.L14 (GND), U3.L22 (GND), U3.M9 (GND), U3.M13 (GND), U3.M15 (GND), U3.M19 (GND), U3.N6 (GND), U3.N8 (GND), U3.N10 (GND), U3.N14 (GND), U3.N16 (GND), U3.P3 (GND), U3.P9 (GND), U3.P11 (GND), U3.P13 (GND), U3.P15 (GND), U3.R8 (GND), U3.R10 (GND), U3.R12 (GND), U3.R14 (GND), U3.R20 (GND), U3.T7 (GND), U3.T17 (GND), U3.U4 (GND), U3.U14 (GND), U3.V1 (GND), U3.V11 (GND), U3.V21 (GND), U3.W8 (GND), U3.W18 (GND), U3.Y5 (GND), U3.Y15 (GND)
VDDQ: C27.1, C31.1, C35.1, C39.1, C43.1, C47.1, C51.1, C55.1, C61.1, C65.1, C69.1, C73.1, C76.1, C80.1

Notes on the sheet:
Decoupling referenced from 7 Series FPGAs PCB Design Guide UG483
UNUSED
VCCBATT max: 2.0V
POWER RAILS
VCCINT max: 1.1V
VCCBRAM max: 1.1V
VCCAUX max: 2.0V
Place close to FPGA banks power supply
VCCADC max: 2.0V
