Singleboardcomputer/hardware_for_kintex/hyperram.kicad_sch

## KiCad design hyperram.kicad_sch (2023-09-25)

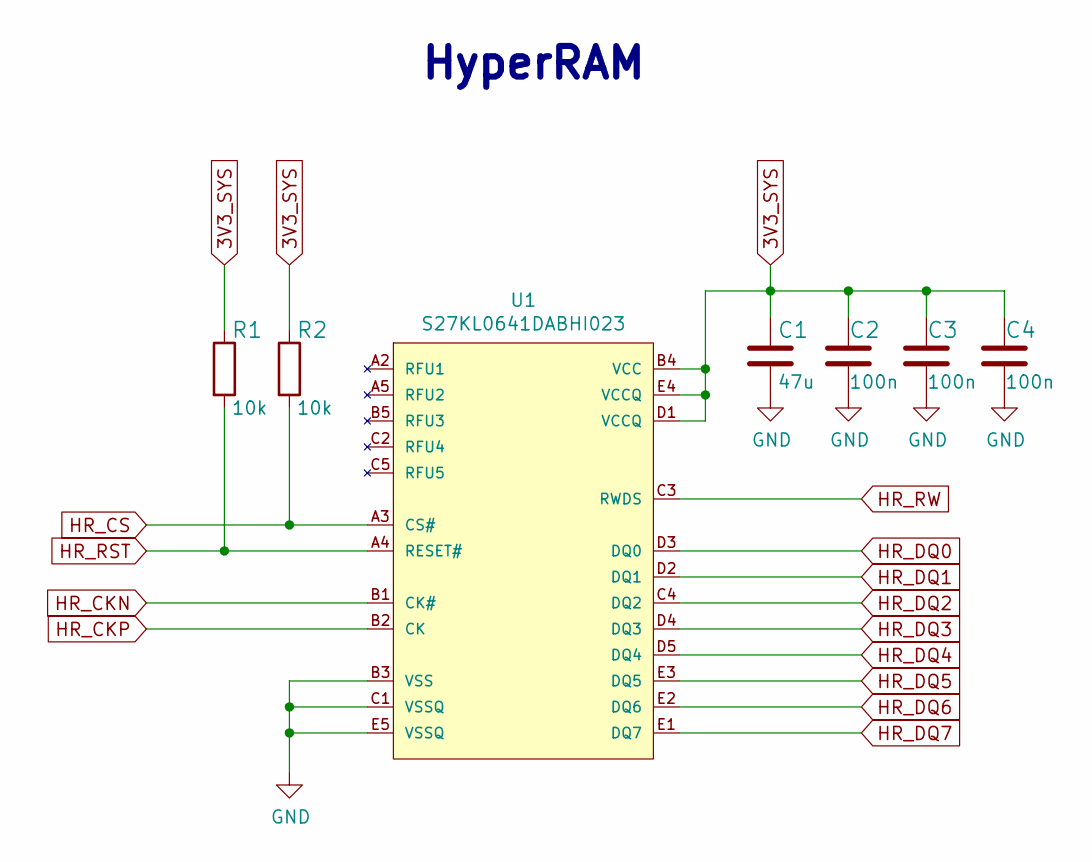
[picture p5: schematic hyperram.kicad_sch]

Parts:
C1: C_47u_0603; 0603-cap; MPN GRM188R60J476ME15D
C2, C3, C4: C_100n_0402_6V3; 0402-cap; MPN 0402X104K6R3CT
R1, R2: R_10k_0402; 0402-res; MPN CRCW040210K0FKEDHP
U1: S27KL0641DABHI023; FBGA-24; MPN S27KL0641DABHI023

Connections:
3V3_SYS: C1.1, C2.1, C3.1, C4.1, R1.1, R2.1, U1.B4 (VCC), U1.D1 (VCCQ), U1.E4 (VCCQ)
GND: C1.2, C2.2, C3.2, C4.2, U1.B3 (VSS), U1.C1 (VSSQ), U1.E5 (VSSQ)
HR_CKN: U1.B1 (CK#)
HR_CKP: U1.B2 (CK)
HR_CS: R2.2, U1.A3 (CS#)
HR_DQ0: U1.D3 (DQ0)
HR_DQ1: U1.D2 (DQ1)
HR_DQ2: U1.C4 (DQ2)
HR_DQ3: U1.D4 (DQ3)
HR_DQ4: U1.D5 (DQ4)
HR_DQ5: U1.E3 (DQ5)
HR_DQ6: U1.E2 (DQ6)
HR_DQ7: U1.E1 (DQ7)
HR_RST: R1.2, U1.A4 (RESET#)
HR_RW: U1.C3 (RWDS)

Notes on the sheet:
HyperRAM
