Singleboardcomputer/hardware_for_kintex/interfaces.kicad_sch

## KiCad design interfaces.kicad_sch (2023-09-25)

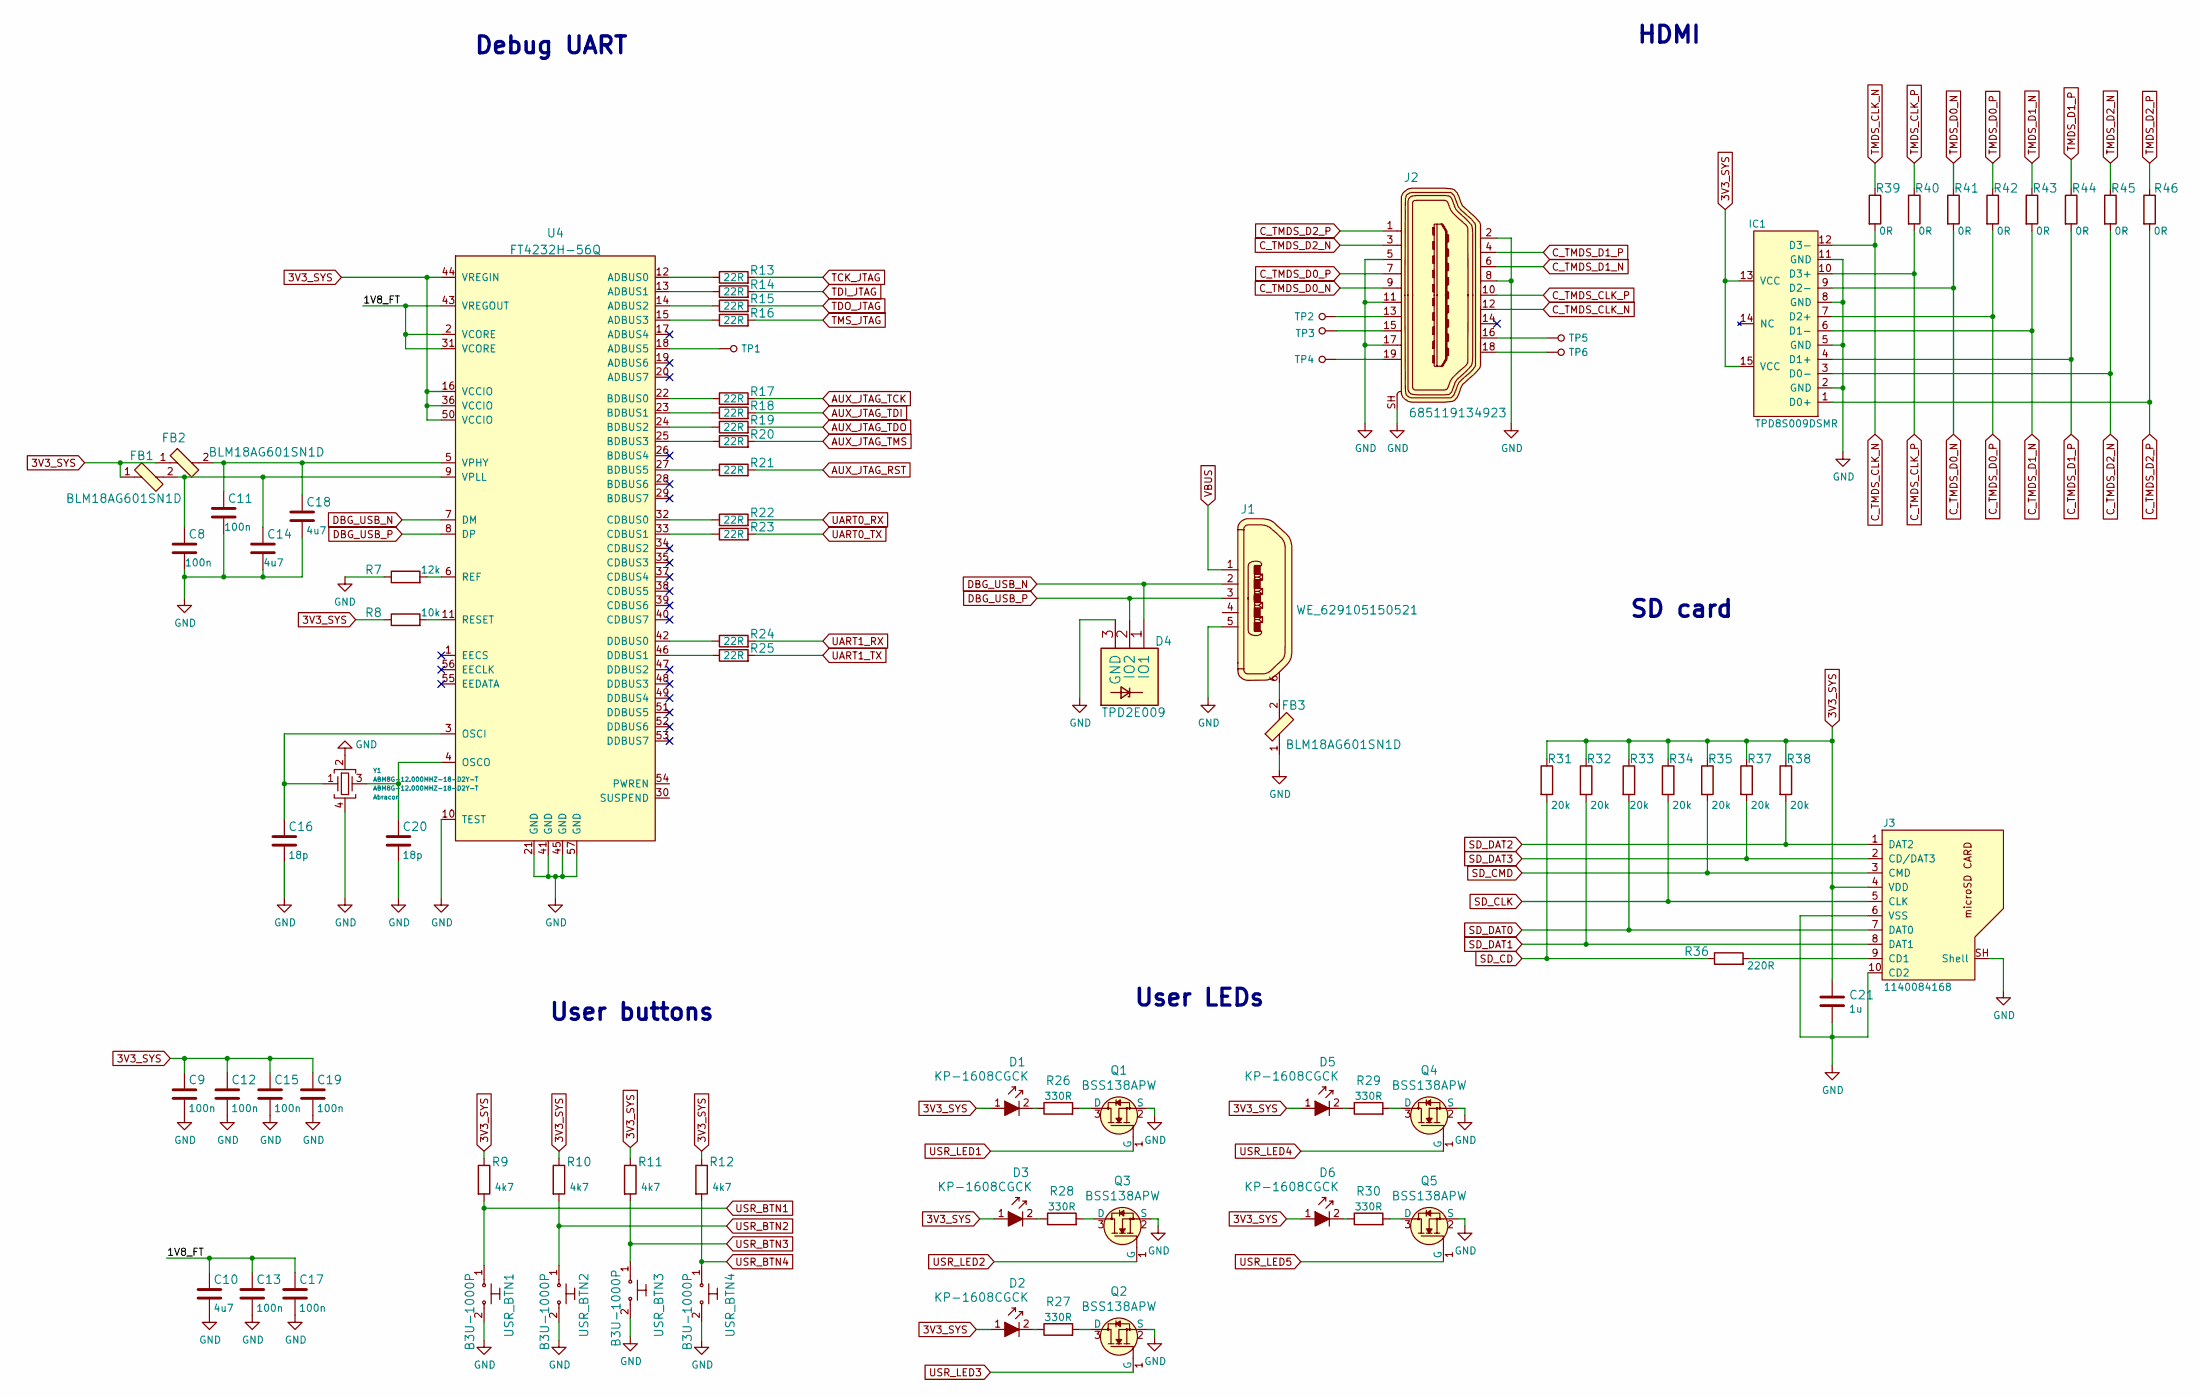
[picture p6: schematic interfaces.kicad_sch]

Parts:
C8, C9, C11, C12, C13, C15, C17, C19: C_100n_0402_6V3; 0402-cap; MPN 0402X104K6R3CT
C10, C14, C18: C_4u7_0402; 0402-cap; MPN GRM155R61A475MEAAD
C16, C20: C_18p_0402; 0402-cap; MPN MC0402N180J500CT
C21: C_1u_0603; 0603-cap; MPN 0603YD105KAT2A
D1, D2, D3, D5, D6: KP-1608CGCK; LED_0603; MPN KP-1608CGCK
D4: TPD2E009; SOT-3; MPN TPD2E009DRTR
FB1, FB2, FB3: BLM18AG601SN1D; 0603; MPN BLM18AG601SN1D
IC1: TPD8S009DSMR; R-PDSO-N15; MPN TPD8S009DSMR
J1: WE_629105150521; USB_Micro_B_Female_629105150521; MPN 629105150521
J2: 685119134923; HDMI_A_Female_685119134923; MPN 685119134923
J3: 1140084168; MicroSD_1140084168; MPN 1140084168
Q1, Q2, Q3, Q4, Q5: BSS138APW; SC70-3; MPN BSS138PW
R7: R_12k_0402; 0402-res; MPN CRCW040212K0FKEDHP
R8: R_10k_0402; 0402-res; MPN CRCW040210K0FKEDHP
R9, R10, R11, R12: R_4k7_0402; 0402-res; MPN ERJ2GEJ472X
R13, R14, R15, R16, R17, R18, R19, R20, R21, R22, R23, R24, R25: R_22R_0402; 0402-res; MPN CRCW040222R0FKED
R26, R27, R28, R29, R30: R_330R_0402; 0402-res; MPN MCMR04X3300FTL
R31, R32, R33, R34, R35, R37, R38: R_20k_0402; 0402-res; MPN CRCW040220K0FKED
R36: R_220R_0402; 0402-res; MPN ERJ2GEJ221X
R39, R40, R41, R42, R43, R44, R45, R46: R_0R_0402; 0402-res; MPN ERJ2GE0R00X
TP1, TP2, TP3, TP4, TP5, TP6: TP_SMD1MM; Testpoint_smd_1mm
U4: FT4232H-56Q; QFN-56-1EP_8x8mm_P0.5mm_EP5.5.9x5.9mm; MPN FT4232H-56Q-REEL
USR_BTN1, USR_BTN2, USR_BTN3, USR_BTN4: B3U-1000P; Switch_Tactile_SMD_B3U-1000P; MPN B3U-1000P
Y1: ABM8G-12.000MHZ-18-D2Y-T; KX-7; MPN ABM8G-12.000MHZ-18-D2Y-T

Connections:
1V8_FT: C10.1, C13.1, C17.1, U4.2 (VCORE), U4.31 (VCORE), U4.43 (VREGOUT)
3V3_SYS: C9.1, C12.1, C15.1, C19.1, C21.1, D1.1, D2.1, D3.1, D5.1, D6.1, FB1.1, FB2.1, IC1.13 (VCC), IC1.15 (VCC), J3.4 (VDD), R8.1, R9.1, R10.1, R11.1, R12.1, R31.1, R32.1, R33.1, R34.1, R35.1, R37.1, R38.1, U4.16 (VCCIO), U4.36 (VCCIO), U4.44 (VREGIN), U4.50 (VCCIO)
AUX_JTAG_RST: R21.2
AUX_JTAG_TCK: R17.2
AUX_JTAG_TDI: R18.2
AUX_JTAG_TDO: R19.2
AUX_JTAG_TMS: R20.2
C_TMDS_CLK_N: IC1.12 (D3-), J2.12, R39.2
C_TMDS_CLK_P: IC1.10 (D3+), J2.10, R40.2
C_TMDS_D0_N: IC1.9 (D2-), J2.9, R41.2
C_TMDS_D0_P: IC1.7 (D2+), J2.7, R42.2
C_TMDS_D1_N: IC1.6 (D1-), J2.6, R43.2
C_TMDS_D1_P: IC1.4 (D1+), J2.4, R44.2
C_TMDS_D2_N: IC1.3 (D0-), J2.3, R45.2
C_TMDS_D2_P: IC1.1 (D0+), J2.1, R46.2
DBG_USB_N: D4.1 (IO1), J1.2, U4.7 (DM)
DBG_USB_P: D4.2 (IO2), J1.3, U4.8 (DP)
GND: C8.2, C9.2, C10.2, C11.2, C12.2, C13.2, C14.2, C15.2, C16.2, C17.2, C18.2, C19.2, C20.2, C21.2, D4.3 (GND), FB3.1, IC1.2 (GND), IC1.5 (GND), IC1.8 (GND), IC1.11 (GND), J1.5, J2.2, J2.5, J2.8, J2.11, J2.17, J2.SH, J3.6 (VSS), J3.10 (CD2), J3.SH (Shell), Q1.2 (S), Q2.2 (S), Q3.2 (S), Q4.2 (S), Q5.2 (S), R7.1, U4.10 (TEST), U4.21 (GND), U4.41 (GND), U4.45 (GND), U4.57 (GND), USR_BTN1.2, USR_BTN2.2, USR_BTN3.2, USR_BTN4.2, Y1.2, Y1.4
unnamed: C11.1, C18.1, FB2.2, U4.5 (VPHY)
unnamed: C8.1, C14.1, FB1.2, U4.9 (VPLL)
unnamed: C16.1, U4.3 (OSCI), Y1.1
unnamed: C20.1, U4.4 (OSCO), Y1.3
unnamed: D1.2, R26.1
unnamed: D2.2, R27.1
unnamed: D3.2, R28.1
unnamed: D5.2, R29.1
unnamed: D6.2, R30.1
unnamed: FB3.2, J1.6
unnamed: J2.13, TP2.1
unnamed: J2.15, TP3.1
unnamed: J2.16, TP5.1
unnamed: J2.18, TP6.1
unnamed: J2.19, TP4.1
unnamed: J3.9 (CD1), R36.2
unnamed: Q1.3 (D), R26.2
unnamed: Q2.3 (D), R27.2
unnamed: Q3.3 (D), R28.2
unnamed: Q4.3 (D), R29.2
unnamed: Q5.3 (D), R30.2
unnamed: R7.2, U4.6 (REF)
unnamed: R8.2, U4.11 (RESET)
unnamed: R13.1, U4.12 (ADBUS0)
unnamed: R14.1, U4.13 (ADBUS1)
unnamed: R15.1, U4.14 (ADBUS2)
unnamed: R16.1, U4.15 (ADBUS3)
unnamed: R17.1, U4.22 (BDBUS0)
unnamed: R18.1, U4.23 (BDBUS1)
unnamed: R19.1, U4.24 (BDBUS2)
unnamed: R20.1, U4.25 (BDBUS3)
unnamed: R21.1, U4.27 (BDBUS5)
unnamed: R22.1, U4.32 (CDBUS0)
unnamed: R23.1, U4.33 (CDBUS1)
unnamed: R24.1, U4.42 (DDBUS0)
unnamed: R25.1, U4.46 (DDBUS1)
unnamed: TP1.1, U4.18 (ADBUS5)
SD_CD: R31.2, R36.1
SD_CLK: J3.5 (CLK), R34.2
SD_CMD: J3.3 (CMD), R35.2
SD_DAT0: J3.7 (DAT0), R33.2
SD_DAT1: J3.8 (DAT1), R32.2
SD_DAT2: J3.1 (DAT2), R38.2
SD_DAT3: J3.2 (CD/DAT3), R37.2
TCK_JTAG: R13.2
TDI_JTAG: R14.2
TDO_JTAG: R15.2
TMDS_CLK_N: R39.1
TMDS_CLK_P: R40.1
TMDS_D0_N: R41.1
TMDS_D0_P: R42.1
TMDS_D1_N: R43.1
TMDS_D1_P: R44.1
TMDS_D2_N: R45.1
TMDS_D2_P: R46.1
TMS_JTAG: R16.2
UART0_RX: R22.2
UART0_TX: R23.2
UART1_RX: R24.2
UART1_TX: R25.2
USR_BTN1: R9.2, USR_BTN1.1
USR_BTN2: R10.2, USR_BTN2.1
USR_BTN3: R11.2, USR_BTN3.1
USR_BTN4: R12.2, USR_BTN4.1
USR_LED1: Q1.1 (G)
USR_LED2: Q3.1 (G)
USR_LED3: Q2.1 (G)
USR_LED4: Q4.1 (G)
USR_LED5: Q5.1 (G)
VBUS: J1.1

Notes on the sheet:
Debug UART
SD card
User LEDs
HDMI
User buttons
