Singleboardcomputer/hardware_for_kintex/lpddr4-test-board.kicad_sch

## KiCad design lpddr4-test-board.kicad_sch (2023-09-25)

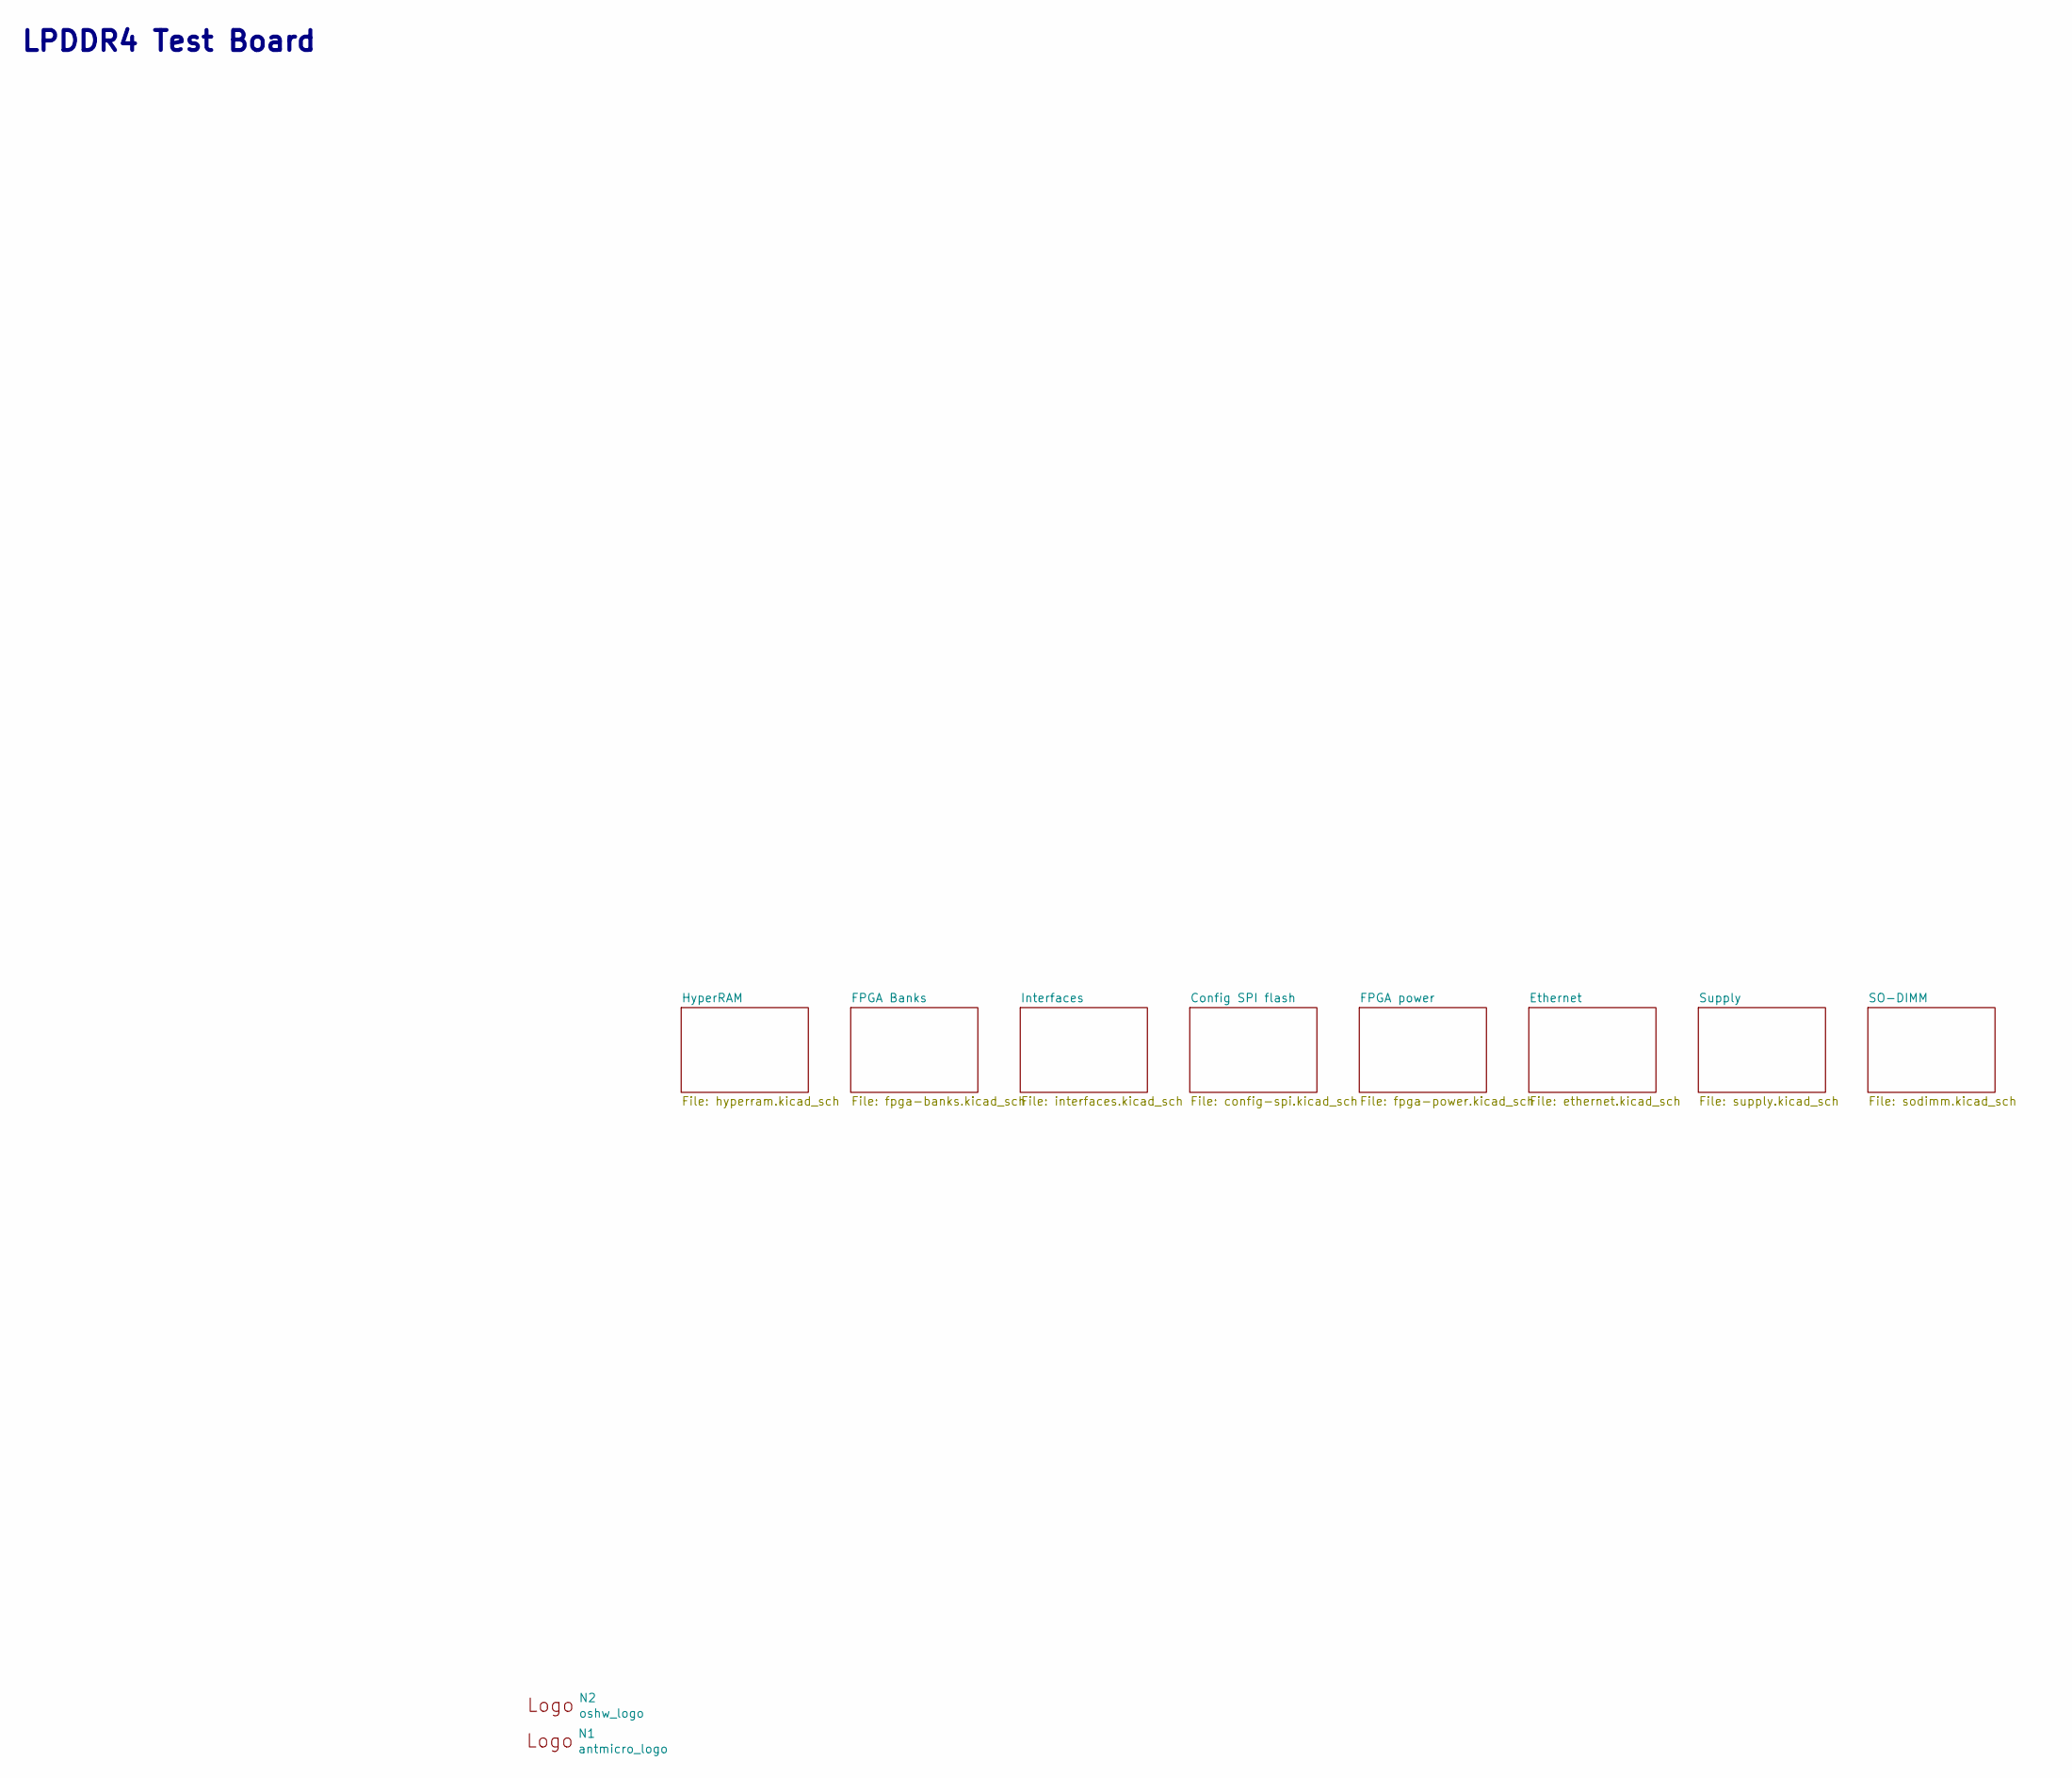
[picture p7: schematic lpddr4-test-board.kicad_sch]

Parts:
N1: antmicro_logo; antmicro-logo_scaled_20mm
N2: oshw_logo; oshw-logo

Notes on the sheet:
LPDDR4 Test Board
