Singleboardcomputer/hardware_for_kintex/sodimm.kicad_sch

## KiCad design sodimm.kicad_sch (2023-09-25)

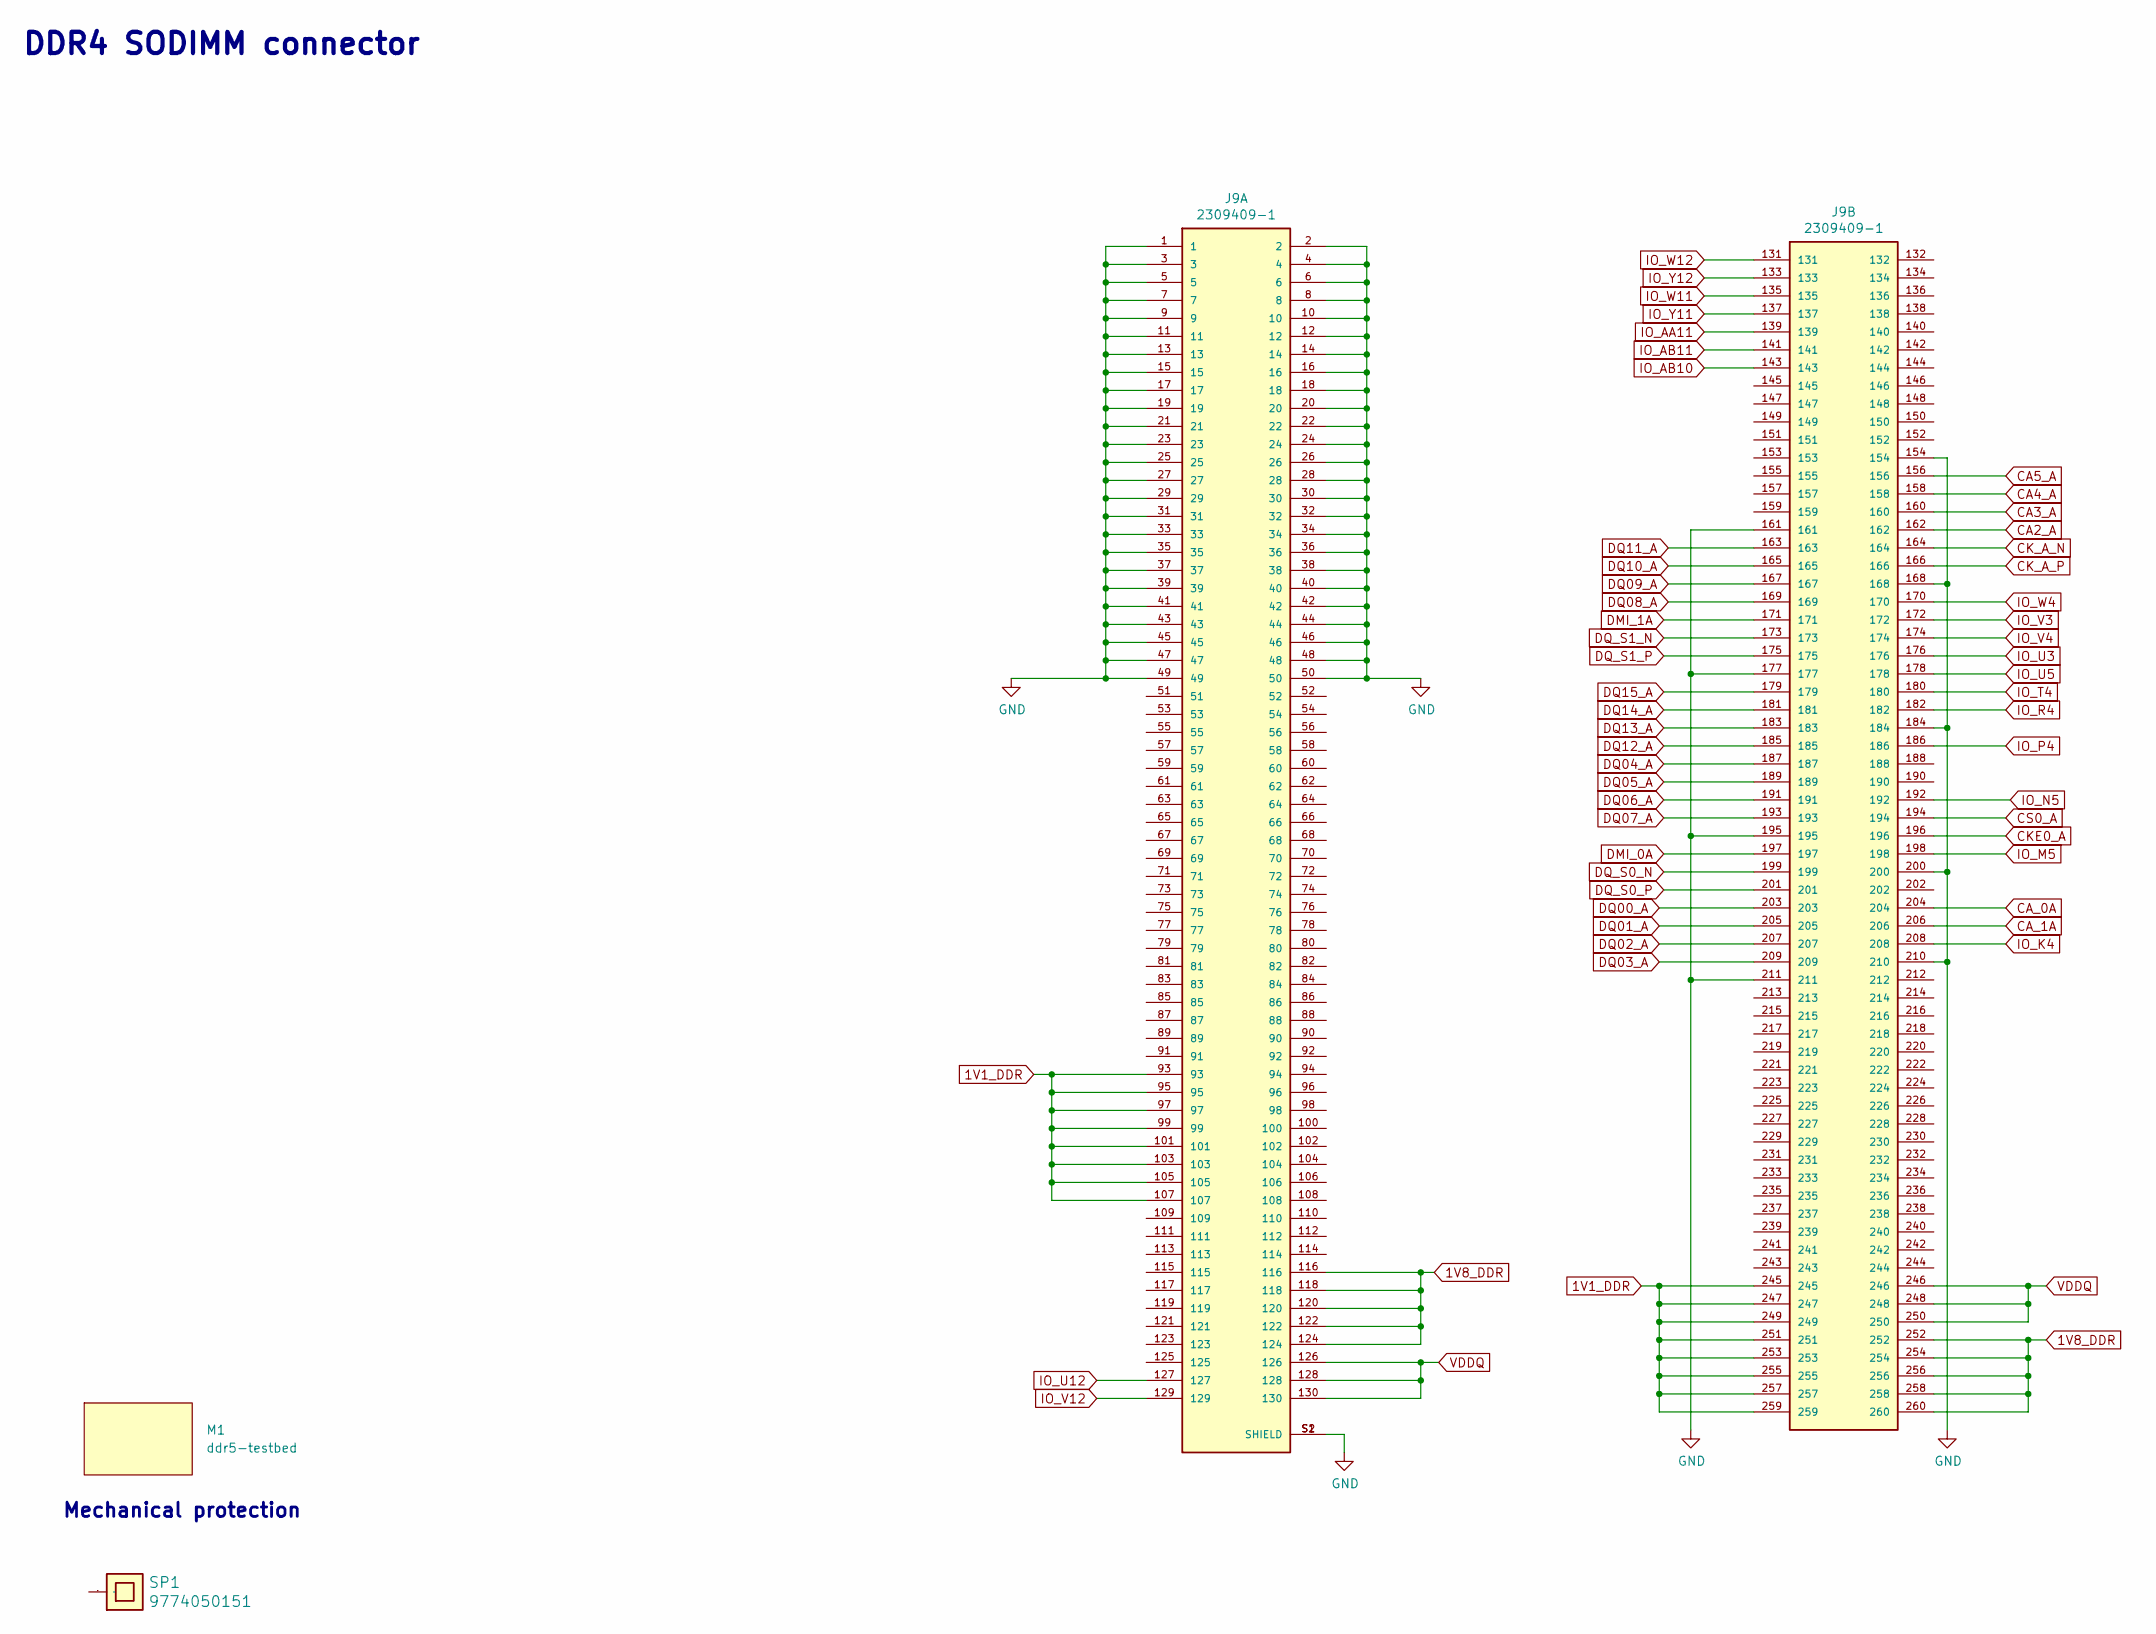
[picture p8: schematic sodimm.kicad_sch]

Parts:
J9: 2309409-1; TE_2309409-1; MPN 2309409-1
M1: ddr5-testbed; DDR5-testbed
SP1: 9774050151; MPN 9774050151

Connections:
1V1_DDR: J9.93, J9.95, J9.97, J9.99, J9.101, J9.103, J9.105, J9.107, J9.245, J9.247, J9.249, J9.251, J9.253, J9.255, J9.257, J9.259
1V8_DDR: J9.116, J9.118, J9.120, J9.122, J9.124, J9.252, J9.254, J9.256, J9.258, J9.260
CA2_A: J9.162
CA3_A: J9.160
CA4_A: J9.158
CA5_A: J9.156
CA_0A: J9.204
CA_1A: J9.206
CKE0_A: J9.196
CK_A_N: J9.164
CK_A_P: J9.166
CS0_A: J9.194
DMI_0A: J9.197
DMI_1A: J9.171
DQ00_A: J9.203
DQ01_A: J9.205
DQ02_A: J9.207
DQ03_A: J9.209
DQ04_A: J9.187
DQ05_A: J9.189
DQ06_A: J9.191
DQ07_A: J9.193
DQ08_A: J9.169
DQ09_A: J9.167
DQ10_A: J9.165
DQ11_A: J9.163
DQ12_A: J9.185
DQ13_A: J9.183
DQ14_A: J9.181
DQ15_A: J9.179
DQ_S0_N: J9.199
DQ_S0_P: J9.201
DQ_S1_N: J9.173
DQ_S1_P: J9.175
GND: J9.1, J9.2, J9.3, J9.4, J9.5, J9.6, J9.7, J9.8, J9.9, J9.10, J9.11, J9.12, J9.13, J9.14, J9.15, J9.16, J9.17, J9.18, J9.19, J9.20, J9.21, J9.22, J9.23, J9.24, J9.25, J9.26, J9.27, J9.28, J9.29, J9.30, J9.31, J9.32, J9.33, J9.34, J9.35, J9.36, J9.37, J9.38, J9.39, J9.40, J9.41, J9.42, J9.43, J9.44, J9.45, J9.46, J9.47, J9.48, J9.49, J9.50, J9.154, J9.161, J9.168, J9.177, J9.184, J9.195, J9.200, J9.210, J9.211, J9.S1 (SHIELD), J9.S2 (SHIELD)
IO_AA11: J9.139
IO_AB10: J9.143
IO_AB11: J9.141
IO_K4: J9.208
IO_M5: J9.198
IO_N5: J9.192
IO_P4: J9.186
IO_R4: J9.182
IO_T4: J9.180
IO_U3: J9.176
IO_U5: J9.178
IO_U12: J9.127
IO_V3: J9.172
IO_V4: J9.174
IO_V12: J9.129
IO_W4: J9.170
IO_W11: J9.135
IO_W12: J9.131
IO_Y11: J9.137
IO_Y12: J9.133
VDDQ: J9.126, J9.128, J9.130, J9.246, J9.248, J9.250

Notes on the sheet:
DDR4 SODIMM connector
Mechanical protection
