Singleboardcomputer/hardware_for_kintex/supply.kicad_sch

## KiCad design supply.kicad_sch (2023-09-25)

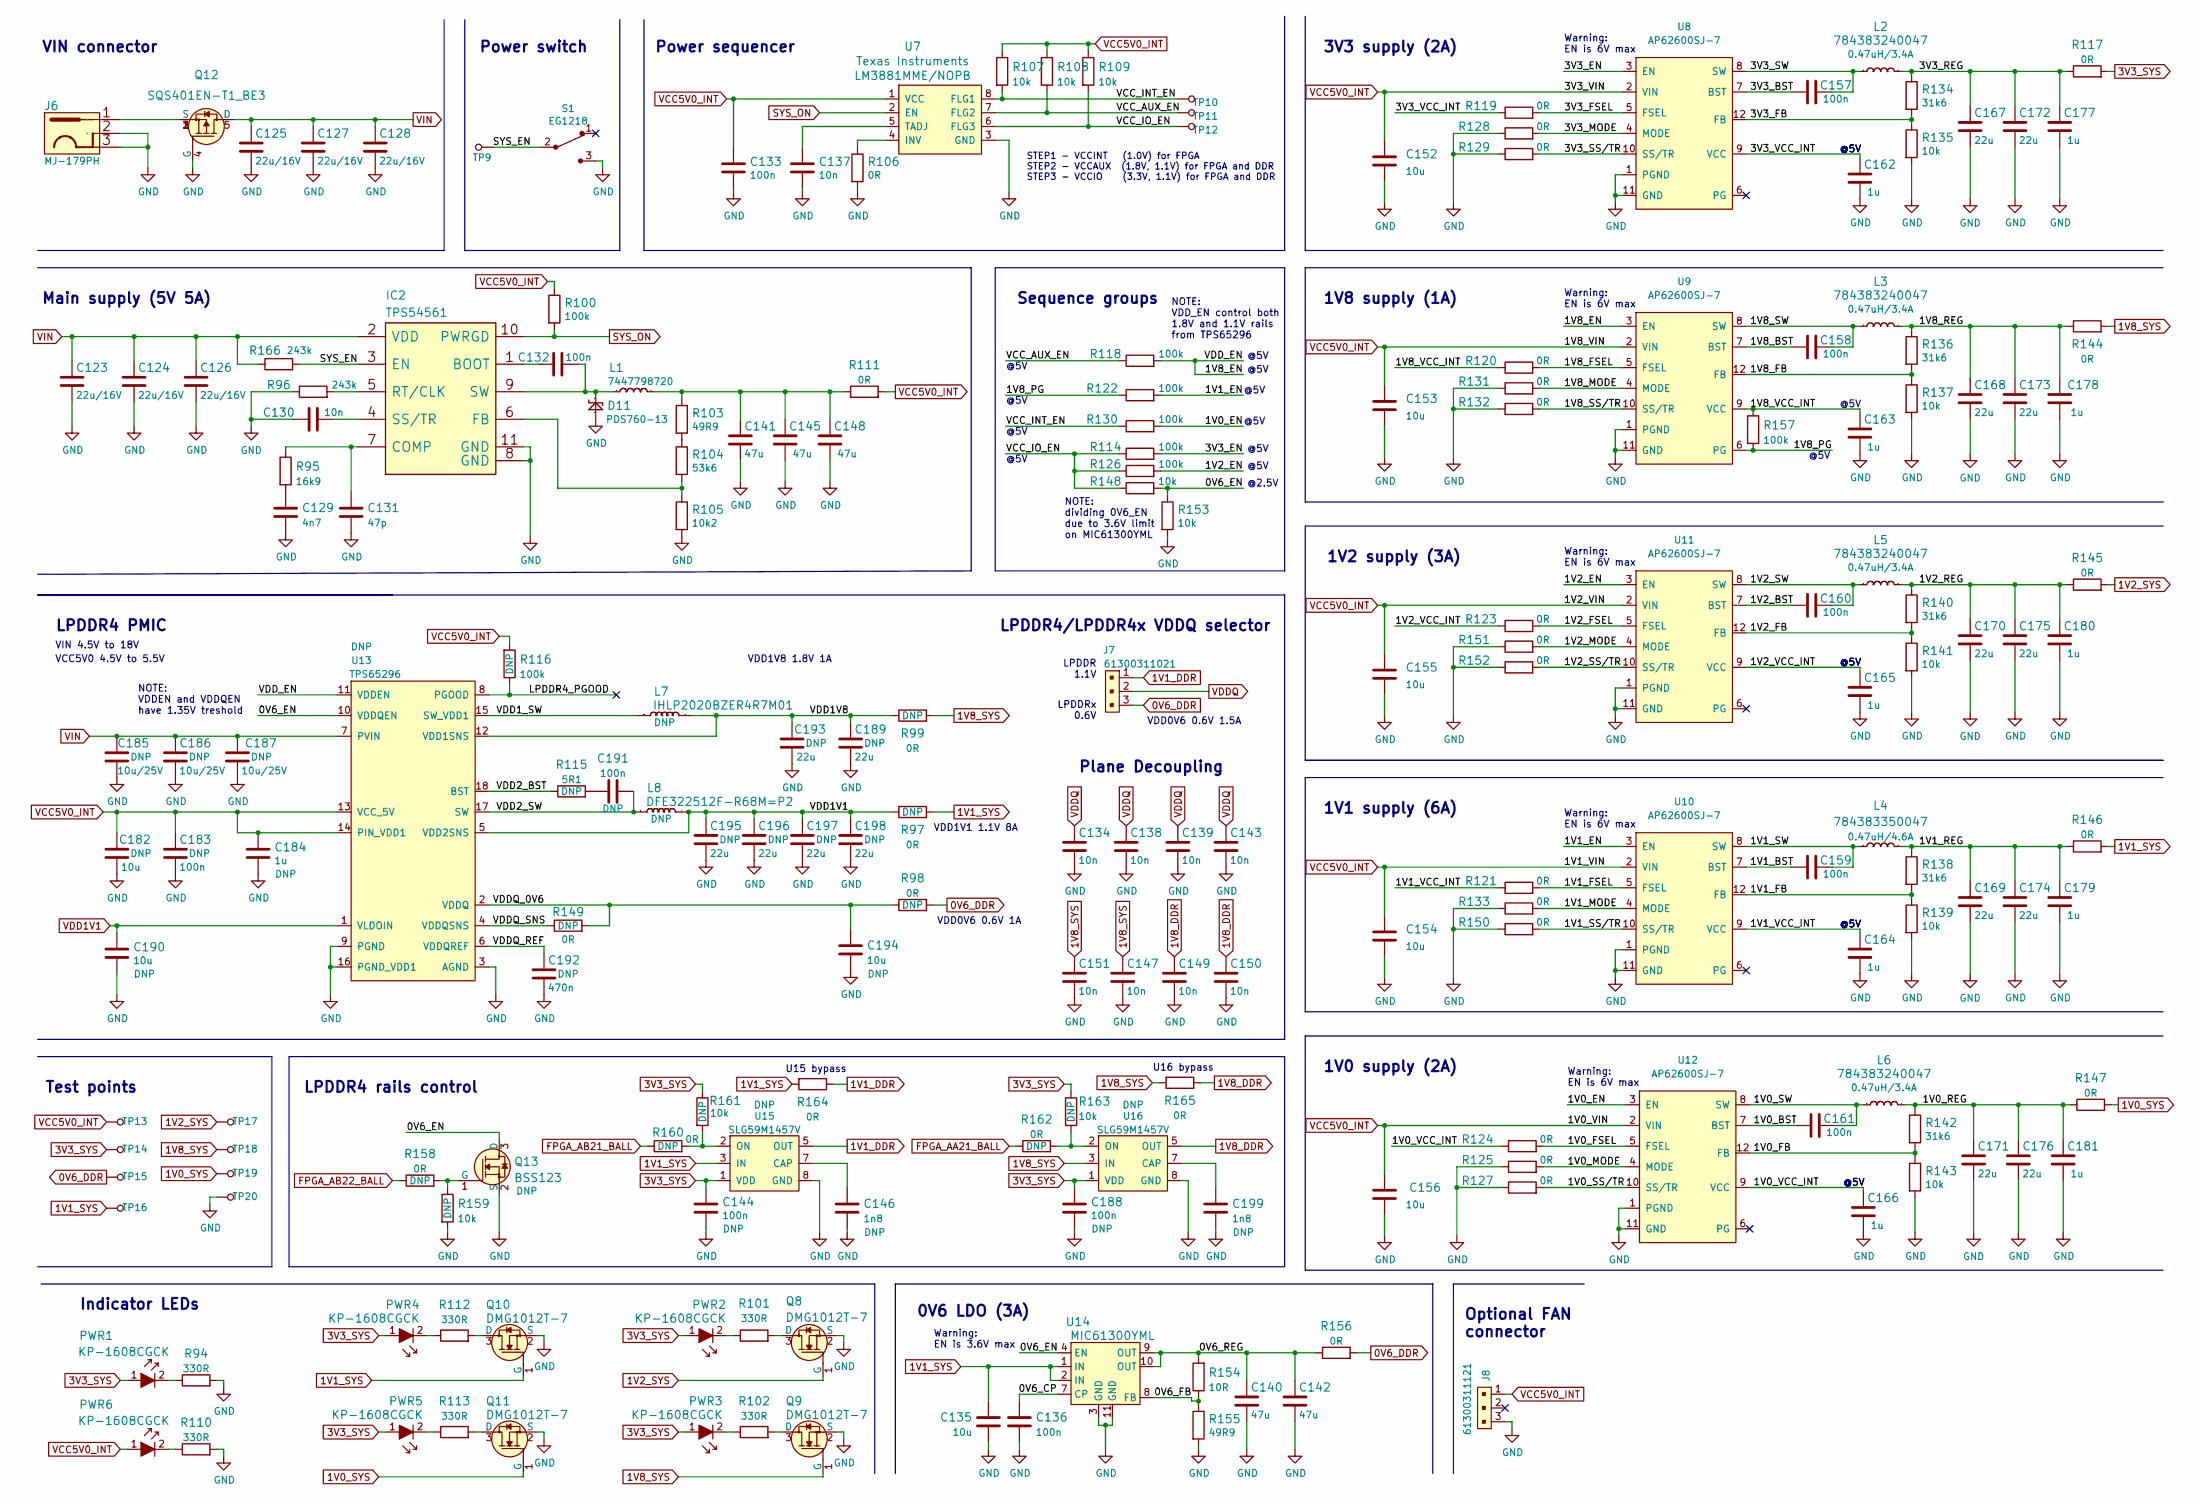
[picture p9: schematic supply.kicad_sch]

Parts:
C123, C124, C125, C126, C127, C128: C_22u_0805_16V; 0805-cap; MPN GRT21BR61C226ME13L
C129: C_4n7_0402; 0402-cap; MPN CGA2B3X7S2A472K050BB
C130: C_10n_0402; 0402-cap; MPN 04025G103ZAT2A
C131: C_47p_0402; 0402-cap; MPN C0402C470J5GACTU
C132, C133, C136, C144, C157, C158, C159, C160, C161, C188, C191: C_100n_0402_6V3; 0402-cap; MPN 0402X104K6R3CT
C134, C137, C138, C139, C143, C147, C149, C150, C151: C_10n_0603; 0603-cap; MPN 06031C103JAT2A
C135, C152, C153, C154, C155, C156, C194: C_10u_0402; 0402-cap; MPN GRM155R60J106ME44D
C140, C141, C142, C145, C148: C_47u_0603; 0603-cap; MPN GRM188R60J476ME15D
C146, C199: C_1n8_0402; 0402-cap; MPN 0402B182K500CT
C162, C163, C164, C165, C166, C177, C178, C179, C180, C181: C_1u_0402; 0402-cap; MPN C1005X6S1A105K050BC
C167, C168, C169, C170, C171, C172, C173, C174, C175, C176: C_22u_0402; 0402-res; MPN 04024W226MAT2A
C182, C190: C_10u_0603; 0603-cap; MPN GRM188R61A106KE69D
C183: C_100n_0603; 0603-cap; MPN 0603YC104KAZ2A
C184: C_1u_0603; 0603-cap; MPN 0603YD105KAT2A
C185, C186, C187: C_10u_25V_0603; 0603-cap; MPN C1608X5R1E106M080AC
C189, C193, C195, C196, C197, C198: C_22u_0603; 0603-cap; MPN GRM188R60J226MEA0D
C192: C_470n_0402; 0402-cap; MPN C1005X5R1E474M050BB
D11: PDS760-13; MPN PDS760-13
IC2: TPS54561; WSON-10_4x4; MPN TPS54561-Q1
J6: DC_SOCKET; MPN MJ-179PH
J7: 61300311021; PinHeader_1x03_P2.54mm_Horizontal; MPN 61300311121
J8: 61300311121; PinHeader_1x3_P2.54_Drill1.1mm; MPN 61300311121
L1: WE_7447798720; MPN 7447798720
L2, L3, L5, L6: 784383240047; L_Wuerth_MAIA-2512; MPN 784383240047
L4: 784383350047; L_Wuerth_MAIA-3015; MPN 784383350047
L7: IHLP2020BZER4R7M01; MPN IHLP1212AEERR47M11
L8: DFE322512F-R68M=P2; INDC3225X120N; MPN IHLP1212AEERR47M11
PWR1, PWR2, PWR3, PWR4, PWR5, PWR6: KP-1608CGCK; LED_0603; MPN KP-1608CGCK
Q8, Q9, Q10, Q11: DMG1012T-7; SOT-523; MPN DMG1012T-7
Q12: SQS401EN-T1_BE3; Vishay_PowerPAK_1212-8_Single; MPN SQS401EN-T1_BE3
Q13: BSS123; SOT-23-3; MPN BSS123
R94, R101, R102, R110, R112, R113: R_330R_0402; 0402-res; MPN MCMR04X3300FTL
R95: R_16k9_0402; 0402-res; MPN ERA2AEB1692X
R96, R166: R_243k_0402; 0402-res; MPN MCMR04X2433FTL
R97, R98, R99, R111, R117, R144, R145, R146, R147, R156, R164, R165: R_0R_0805; 0805-res; MPN CRCW08050000Z0EA
R100, R114, R116, R118, R122, R126, R130, R157: R_100k_0402; 0402-res; MPN CRCW0402100KFKEDHP
R103, R155: R_49R9_0402; 0402-res; MPN CRCW040249R9FKED
R104: R_53k6_0402; 0402-res; MPN CPF0402B53K6E1_
R105: R_10k2_0402; 0402-res; MPN MCWR04X1022FTL
R106, R119, R120, R121, R123, R124, R125, R127, R128, R129, R131, R132, R133, R149, R150, R151, R152, R158, R160, R162: R_0R_0402; 0402-res; MPN ERJ2GE0R00X
R107, R108, R109, R135, R137, R139, R141, R143, R148, R153, R159, R161, R163: R_10k_0402; 0402-res; MPN CRCW040210K0FKEDHP
R115: R_5R1_0402; 0402-res; MPN ERJ2GEJ5R1X
R134, R136, R138, R140, R142: R_31k6_0402; 0402-res; MPN CRCW040231K6FKEDC
R154: R_10R_1%_0402; 0402-res; MPN CR0402-FX-10R0GLF
S1: EG1218; Switch_Slide_11.6x4mm_EG1218; MPN EG1218
TP9, TP10, TP11, TP12, TP13, TP14, TP15, TP16, TP17, TP18, TP19, TP20: TP_SMD1MM; Testpoint_smd_1mm
U7: LM3881MME_NOPB; VSSOP8-Texas_Instruments-DGK0008A; MPN LM3881MME/NOPB
U8, U9, U10, U11, U12: AP62600SJ-7; V-QFN2030-12; MPN AP62600SJ-7
U13: TPS65296; VQFN-HR; MPN TPS65296RJER
U14: MIC61300YML; DFN-10-1EP_3x3mm; MPN MIC61300YML-TR
U15, U16: SLG59M1457V; RENESAS-TDFN-8-1.5x2.0mm_P0.5mm; MPN SLG59M1457V

Connections:
0V6_CP: C136.2, U14.7 (CP)
0V6_DDR: J7.3, R98.2, R156.2, TP15.1
0V6_EN: Q13.3 (D), R148.2, R153.1, U13.10 (VDDQEN), U14.4 (EN)
0V6_FB: R154.1, R155.1, U14.8 (FB)
0V6_REG: C140.1, C142.1, R154.2, R156.1, U14.9 (OUT), U14.10 (OUT)
1V0_BST: C161.2, U12.7 (BST)
1V0_EN: R130.2, U12.3 (EN)
1V0_FB: R142.2, R143.1, U12.12 (FB)
1V0_FSEL: R124.2, U12.5 (FSEL)
1V0_MODE: R125.2, U12.4 (MODE)
1V0_REG: C171.1, C176.1, C181.1, L6.2, R142.1, R147.1
1V0_SS/TR: R127.2, U12.10 (SS/TR)
1V0_SW: C161.1, L6.1, U12.8 (SW)
1V0_SYS: Q11.1 (G), R147.2, TP19.1
1V0_VCC_INT: C166.1, R124.1, U12.9 (VCC)
1V1_BST: C159.2, U10.7 (BST)
1V1_DDR: J7.1, R164.1, U15.5 (OUT)
1V1_EN: R122.2, U10.3 (EN)
1V1_FB: R138.2, R139.1, U10.12 (FB)
1V1_FSEL: R121.2, U10.5 (FSEL)
1V1_MODE: R133.2, U10.4 (MODE)
1V1_REG: C169.1, C174.1, C179.1, L4.2, R138.1, R146.1
1V1_SS/TR: R150.2, U10.10 (SS/TR)
1V1_SW: C159.1, L4.1, U10.8 (SW)
1V1_SYS: C135.1, Q10.1 (G), R97.2, R146.2, R164.2, TP16.1, U14.1 (IN), U14.2 (IN), U15.3 (IN)
1V1_VCC_INT: C164.1, R121.1, U10.9 (VCC)
1V2_BST: C160.2, U11.7 (BST)
1V2_EN: R126.2, U11.3 (EN)
1V2_FB: R140.2, R141.1, U11.12 (FB)
1V2_FSEL: R123.2, U11.5 (FSEL)
1V2_MODE: R151.2, U11.4 (MODE)
1V2_REG: C170.1, C175.1, C180.1, L5.2, R140.1, R145.1
1V2_SS/TR: R152.2, U11.10 (SS/TR)
1V2_SW: C160.1, L5.1, U11.8 (SW)
1V2_SYS: Q8.1 (G), R145.2, TP17.1
1V2_VCC_INT: C165.1, R123.1, U11.9 (VCC)
1V8_BST: C158.2, U9.7 (BST)
1V8_DDR: C149.1, C150.1, R165.1, U16.5 (OUT)
1V8_EN: R118.2, U9.3 (EN), U13.11 (VDDEN)
1V8_FB: R136.2, R137.1, U9.12 (FB)
1V8_FSEL: R120.2, U9.5 (FSEL)
1V8_MODE: R131.2, U9.4 (MODE)
1V8_PG: R122.1, R157.2, U9.6 (PG)
1V8_REG: C168.1, C173.1, C178.1, L3.2, R136.1, R144.1
1V8_SS/TR: R132.2, U9.10 (SS/TR)
1V8_SW: C158.1, L3.1, U9.8 (SW)
1V8_SYS: C147.1, C151.1, Q9.1 (G), R99.2, R144.2, R165.2, TP18.1, U16.3 (IN)
1V8_VCC_INT: C163.1, R120.1, R157.1, U9.9 (VCC)
3V3_BST: C157.2, U8.7 (BST)
3V3_EN: R114.2, U8.3 (EN)
3V3_FB: R134.2, R135.1, U8.12 (FB)
3V3_FSEL: R119.2, U8.5 (FSEL)
3V3_MODE: R128.2, U8.4 (MODE)
3V3_REG: C167.1, C172.1, C177.1, L2.2, R117.1, R134.1
3V3_SS/TR: R129.2, U8.10 (SS/TR)
3V3_SW: C157.1, L2.1, U8.8 (SW)
3V3_SYS: C144.1, C188.1, PWR1.1, PWR2.1, PWR3.1, PWR4.1, PWR5.1, R117.2, R161.1, R163.1, TP14.1, U15.1 (VDD), U16.1 (VDD)
3V3_VCC_INT: C162.1, R119.1, U8.9 (VCC)
FPGA_AA21_BALL: R162.1
FPGA_AB21_BALL: R160.1
FPGA_AB22_BALL: R158.1
GND: C123.2, C124.2, C125.2, C126.2, C127.2, C128.2, C129.2, C130.2, C131.2, C133.2, C134.2, C135.2, C136.1, C137.1, C138.2, C139.2, C140.2, C141.2, C142.2, C143.2, C144.2, C145.2, C146.2, C147.2, C148.2, C149.2, C150.2, C151.2, C152.2, C153.2, C154.2, C155.2, C156.2, C162.2, C163.2, C164.2, C165.2, C166.2, C167.2, C168.2, C169.2, C170.2, C171.2, C172.2, C173.2, C174.2, C175.2, C176.2, C177.2, C178.2, C179.2, C180.2, C181.2, C182.2, C183.2, C184.2, C185.2, C186.2, C187.2, C188.2, C189.2, C190.2, C192.2, C193.2, C194.2, C195.2, C196.2, C197.2, C198.2, C199.2, D11.A, IC2.8 (GND), IC2.11 (GND), J6.2, J6.3, J8.3, Q8.2 (S), Q9.2 (S), Q10.2 (S), Q11.2 (S), Q12.4 (G), Q13.2 (S), R94.2, R96.1, R105.2, R106.2, R110.2, R125.1, R127.1, R128.1, R129.1, R131.1, R132.1, R133.1, R135.2, R137.2, R139.2, R141.2, R143.2, R150.1, R151.1, R152.1, R153.2, R155.2, R159.2, S1.3, TP20.1, U7.3 (GND), U8.1 (PGND), U8.11 (GND), U9.1 (PGND), U9.11 (GND), U10.1 (PGND), U10.11 (GND), U11.1 (PGND), U11.11 (GND), U12.1 (PGND), U12.11 (GND), U13.3 (AGND), U13.9 (PGND), U13.16 (PGND_VDD1), U14.3 (GND), U14.11 (GND), U15.8 (GND), U16.8 (GND)
LPDDR4_PGOOD: R116.1, U13.8 (PGOOD)
unnamed: C129.1, R95.2
unnamed: C130.1, IC2.4 (SS/TR)
unnamed: C131.1, IC2.7 (COMP), R95.1
unnamed: C132.1, D11.C, IC2.9 (SW), L1.1
unnamed: C132.2, IC2.1 (BOOT)
unnamed: C137.2, U7.5 (TADJ)
unnamed: C141.1, C145.1, C148.1, L1.2, R103.1, R111.1
unnamed: C146.1, U15.7 (CAP)
unnamed: C191.2, R115.2
unnamed: C199.1, U16.7 (CAP)
unnamed: IC2.5 (RT/CLK), R96.2
unnamed: IC2.6 (FB), R104.2, R105.1
unnamed: J6.1, Q12.1 (S), Q12.2 (S), Q12.3 (S)
unnamed: PWR1.2, R94.1
unnamed: PWR2.2, R101.1
unnamed: PWR3.2, R102.1
unnamed: PWR4.2, R112.1
unnamed: PWR5.2, R113.1
unnamed: PWR6.2, R110.1
unnamed: Q8.3 (D), R101.2
unnamed: Q9.3 (D), R102.2
unnamed: Q10.3 (D), R112.2
unnamed: Q11.3 (D), R113.2
unnamed: Q13.1 (G), R158.2, R159.1
unnamed: R103.2, R104.1
unnamed: R106.1, U7.4 (INV)
unnamed: R160.2, R161.2, U15.2 (ON)
unnamed: R162.2, R163.2, U16.2 (ON)
SYS_EN: IC2.3 (EN), R166.2, S1.2, TP9.1
SYS_ON: IC2.10 (PWRGD), R100.2, U7.2 (EN)
VCC5V0_INT: C133.1, C152.1, C153.1, C154.1, C155.1, C156.1, C182.1, C183.1, C184.1, J8.1, PWR6.1, R100.1, R107.1, R108.1, R109.1, R111.2, R116.2, TP13.1, U7.1 (VCC), U8.2 (VIN), U9.2 (VIN), U10.2 (VIN), U11.2 (VIN), U12.2 (VIN), U13.13 (VCC_5V), U13.14 (PIN_VDD1)
VCC_AUX_EN: R108.2, R118.1, TP11.1, U7.7 (FLG2)
VCC_INT_EN: R107.2, R130.1, TP10.1, U7.8 (FLG1)
VCC_IO_EN: R109.2, R114.1, R126.1, R148.1, TP12.1, U7.6 (FLG3)
VDD1V1: C190.1, C195.1, C196.1, C197.1, C198.1, L8.2, R97.1, U13.1 (VLDOIN), U13.5 (VDD2SNS)
VDD1V8: C189.1, C193.1, L7.2, R99.1, U13.12 (VDD1SNS)
VDD1_SW: L7.1, U13.15 (SW_VDD1)
VDD2_BST: R115.1, U13.18 (BST)
VDD2_SW: C191.1, L8.1, U13.17 (SW)
VDDQ: C134.1, C138.1, C139.1, C143.1, J7.2
VDDQ_0V6: C194.1, R98.1, R149.2, U13.2 (VDDQ)
VDDQ_REF: C192.1, U13.6 (VDDQREF)
VDDQ_SNS: R149.1, U13.4 (VDDQSNS)
VIN: C123.1, C124.1, C125.1, C126.1, C127.1, C128.1, C185.1, C186.1, C187.1, IC2.2 (VDD), Q12.5 (D), R166.1, U13.7 (PVIN)

Notes on the sheet:
Warning: EN is 6V max
@5V
Test points
1V8 supply (1A)
Power switch
Optional FAN connector
VDD0V6 0.6V 1A
U16 bypass
U15 bypass
3V3 supply (2A)
VDD1V1 1.1V 8A
Plane Decoupling
0V6 LDO (3A)
LPDDR4 PMIC
Sequence groups
VIN connector
STEP1 - VCCINT (1.0V) for FPGA STEP2 - VCCAUX (1.8V, 1.1V) for FPGA and DDR STEP3 - VCCIO (3.3V, 1.1V) for FPGA and DDR
LPDDRx 0.6V
NOTE: VDD_EN control both 1.8V and 1.1V rails from TPS65296
1V2 supply (3A)
NOTE: dividing 0V6_EN due to 3.6V limit on MIC61300YML
@2.5V
LPDDR4 rails control
Power sequencer
VDD1V8 1.8V 1A
VIN 4.5V to 18V
1V0 supply (2A)
Main supply (5V 5A)
LPDDR 1.1V
NOTE: VDDEN and VDDQEN have 1.35V treshold
VDD0V6 0.6V 1.5A
1V1 supply (6A)
Warning: EN is 3.6V max
LPDDR4/LPDDR4x VDDQ selector
Indicator LEDs
VCC5V0 4.5V to 5.5V
